misadecki/araneo-project/mechanics/araneo-cad.step

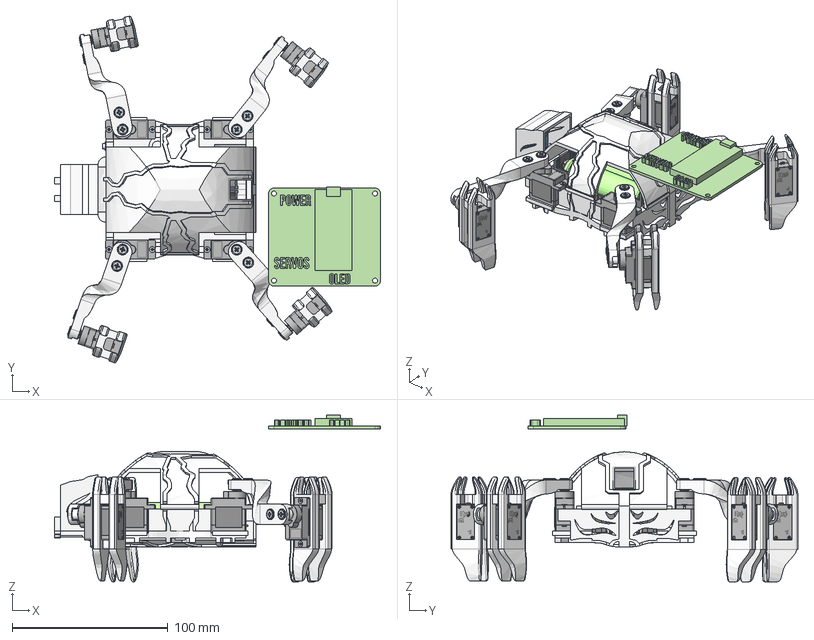
[picture p1: CAD file, 2026-08-21]
mechanics/araneo-cad.step
209.6 x 222.9 x 107.1 mm
SG90 - Micro Servo 9g - Tower Pro.1_Pe?a:1__Body10__SG90 - Micro Serv o 9g - Tower Pro.1_Pe�a:1__Body10 x 8
SG90 - Micro Servo 9g - Tower Pro.1_Pe?a:1__Body1__SG90 - Micro Servo 9g - Tower Pro.1_Pe�a:1__Body1 x 8
Cable Body
PH Countersunk flat head screw M2x0.4 x 6 x 16
SG90 - Micro Servo 9g - Tower Pro.1_Pe?a:1__Body8__SG90 - Micro Servo 9g - Tower Pro.1_Pe�a:1__Body8 x 8
SG90 - Micro Servo 9g - Tower Pro.1_Pe?a:1__Body12__SG90 - Micro Serv o 9g - Tower Pro.1_Pe�a:1__Body12 x 8
SG90 - Micro Servo 9g - Tower Pro.1_Pe?a:1__Body5__SG90 - Micro Servo 9g - Tower Pro.1_Pe�a:1__Body5 x 8
SG90 - Micro Servo 9g - Tower Pro.1_Pe?a:1__Body13__SG90 - Micro Serv o 9g - Tower Pro.1_Pe�a:1__Body13 x 8
Plain washer grade A HV200 M3 x 30
Bottom Body
SG90 - Micro Servo 9g - Tower Pro.1_Pe?a:1__Body11__SG90 - Micro Serv o 9g - Tower Pro.1_Pe�a:1__Body11 x 8
Hex socket head cap screw M2x0.40 x 4 x 2
PH Countersunk flat head screw M3x0.5 x 6 x 30
Pin 4
SG90 - Micro Servo 9g - Tower Pro.1_Pe?a:1__Body7__SG90 - Micro Servo 9g - Tower Pro.1_Pe�a:1__Body7 x 8
SG90 - Micro Servo 9g - Tower Pro.1_Pe?a:1__Body2__SG90 - Micro Servo 9g - Tower Pro.1_Pe�a:1__Body2 x 8
Imported5
Main Body
SG90 - Micro Servo 9g - Tower Pro.1_Pe?a:1__Body3__SG90 - Micro Servo 9g - Tower Pro.1_Pe�a:1__Body3 x 8
SG90 - Micro Servo 9g - Tower Pro.1_Pe?a:1__Body4__SG90 - Micro Servo 9g - Tower Pro.1_Pe�a:1__Body4 x 8
SG90 - Micro Servo 9g - Tower Pro.1_Pe?a:1__Body6__SG90 - Micro Servo 9g - Tower Pro.1_Pe�a:1__Body6 x 8
Mounting Hole 2
SG90 - Micro Servo 9g - Tower Pro.1_Pe?a:1__Body9__SG90 - Micro Servo 9g - Tower Pro.1_Pe�a:1__Body9 x 8
PCB
Cut-Extrude1
Servo Header x 8
Head
Screen
Pin 3
Left Leg x 2
First Pin
Mounting Hole 4
Screen Holder
Mounting Hole 3
Right Leg x 2
Pin 2
Vertical Leg Left x 2
Imported7
Imported6
Imported4
Mounting Hole 1
Vertical Leg Right x 2
Porta_18650__Contacto_2 x 2
Porta_18650__Carcasa x 2
Porta_18650__Contacto_1 x 2
Top Body
Screen Pad
