misadecki/araneo-project/ros2_ws/src/quadruped_description/meshes/femur_left.stl

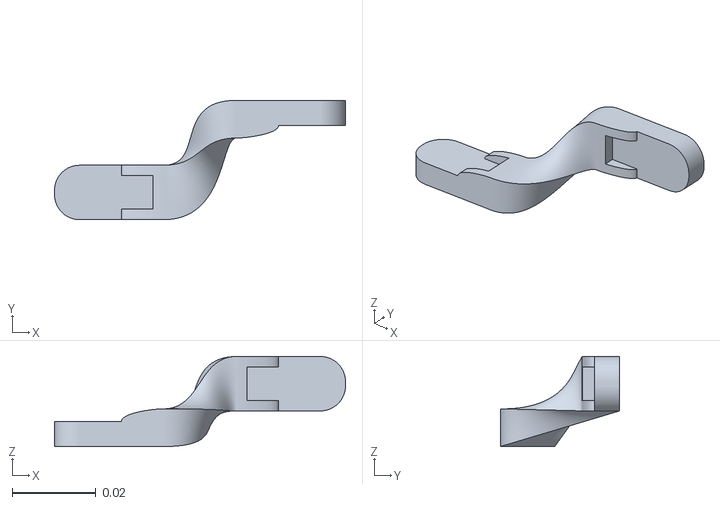
[picture p2: CAD file, 2026-11-03]
ros2_ws/src/quadruped_description/meshes/femur_left.stl
0.0695 x 0.0285 x 0.0215
