misadecki/araneo-project/ros2_ws/src/quadruped_description/meshes/body_bottom.stl

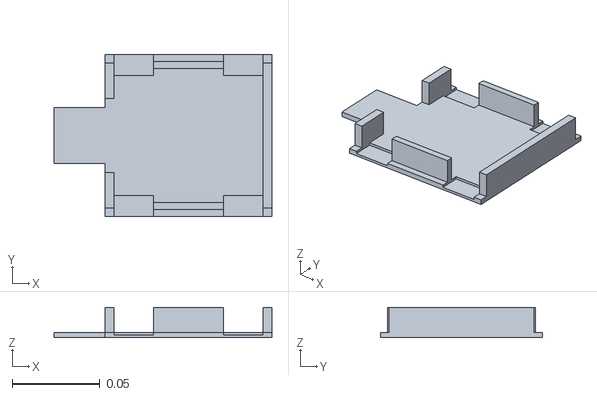
[picture p3: CAD file, 2026-11-03]
ros2_ws/src/quadruped_description/meshes/body_bottom.stl
0.124 x 0.0924 x 0.0172
