misadecki/araneo-project/ros2_ws/src/quadruped_description/meshes/tibia_left.stl

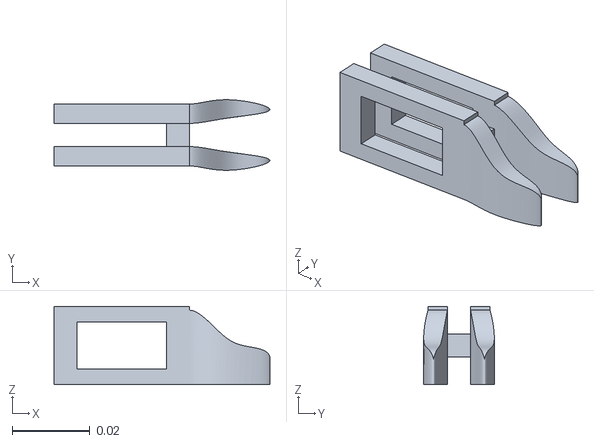
[picture p4: CAD file, 2026-11-03]
ros2_ws/src/quadruped_description/meshes/tibia_left.stl
0.0557 x 0.0182 x 0.0202
