misadecki/araneo-project/ros2_ws/src/quadruped_description/meshes/head.stl

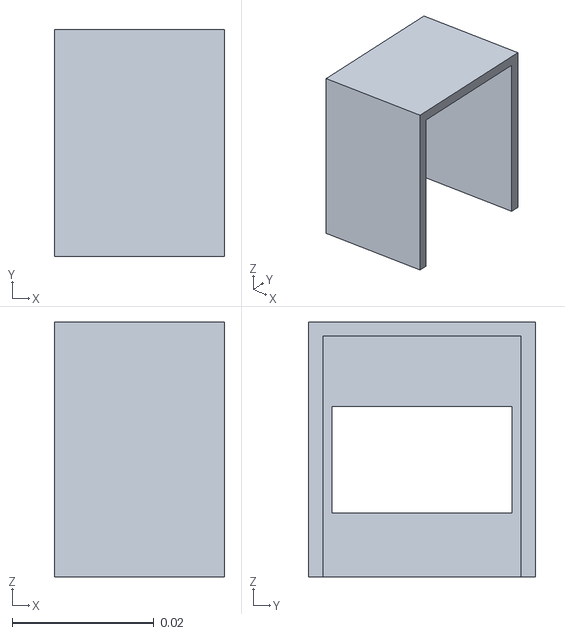
[picture p5: CAD file, 2026-11-03]
ros2_ws/src/quadruped_description/meshes/head.stl
0.024 x 0.032 x 0.036
