misadecki/araneo-project/ros2_ws/src/quadruped_description/meshes/body_top.stl

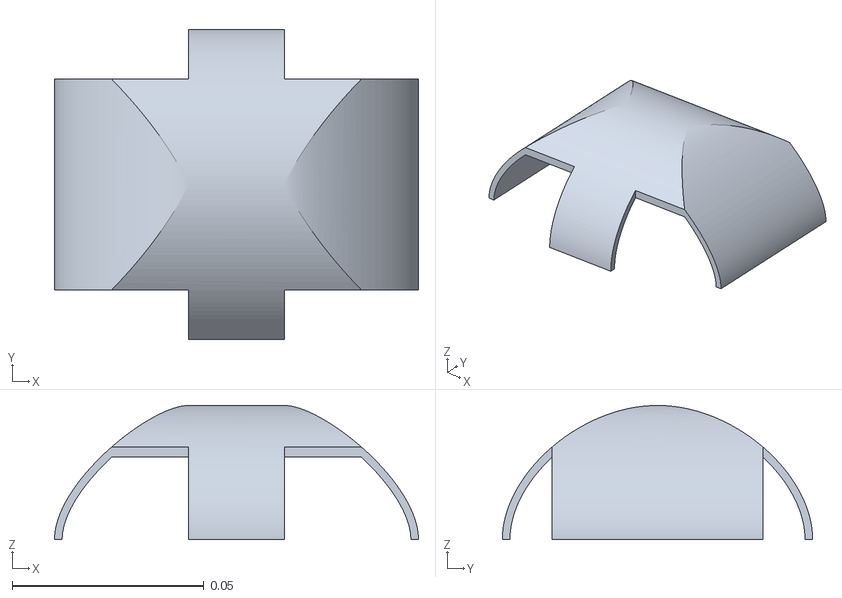
[picture p6: CAD file, 2026-11-03]
ros2_ws/src/quadruped_description/meshes/body_top.stl
0.095 x 0.081 x 0.035
