misadecki/araneo-project/ros2_ws/src/quadruped_description/meshes/electronics.stl

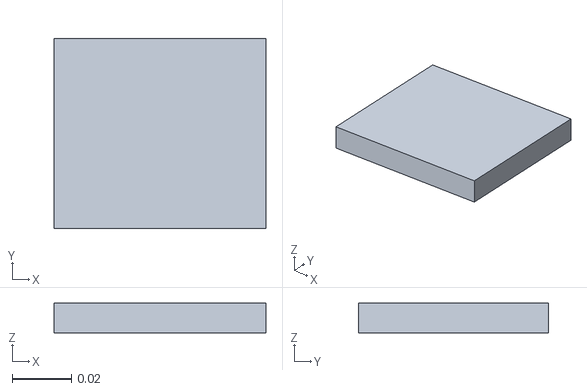
[picture p7: CAD file, 2026-11-03]
ros2_ws/src/quadruped_description/meshes/electronics.stl
0.0715 x 0.064 x 0.01
