misadecki/araneo-project/ros2_ws/src/quadruped_description/meshes/battery.stl

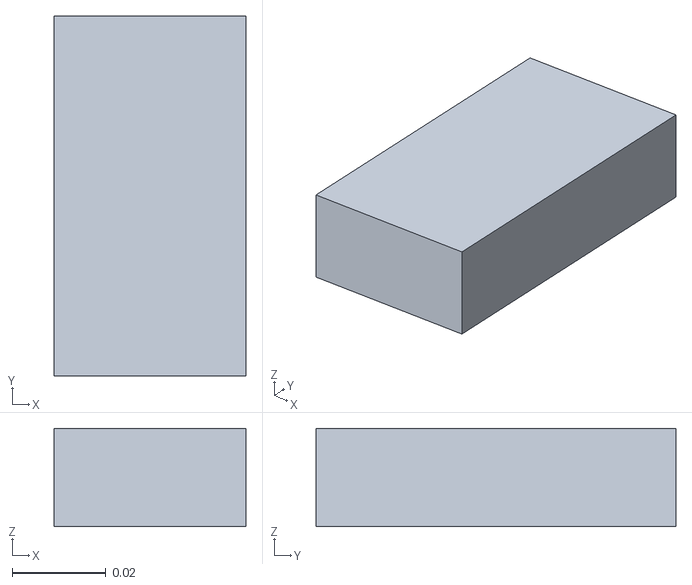
[picture p8: CAD file, 2026-11-03]
ros2_ws/src/quadruped_description/meshes/battery.stl
0.041 x 0.077 x 0.021
