misadecki/araneo-project/ros2_ws/src/quadruped_description/meshes/servo.stl

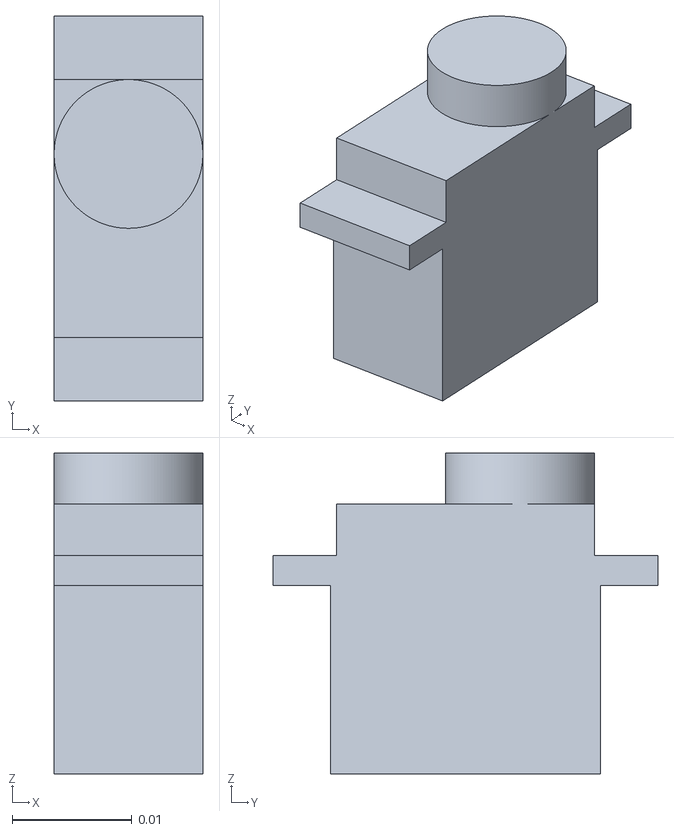
[picture p9: CAD file, 2026-11-03]
ros2_ws/src/quadruped_description/meshes/servo.stl
0.0124 x 0.0321 x 0.0268
