misadecki/araneo-project/(list of files, cad)

Other CAD files:
ros2_ws/src/quadruped_description/meshes/femur_right.stl
ros2_ws/src/quadruped_description/meshes/tibia_right.stl
mechanics/araneo-cad.stl
