misadecki/araneo-project/ros2_ws/src/quadruped_description/urdf/araneo.urdf

<!--URDF generated by ONSHAPE BY PTC INC, 1.223-->
<robot name="quadruped_description">
    <link name="battery">
        <inertial>
            <mass value="6.6297e-05" />
            <origin xyz="-7.51456e-18 5.50052e-18 0.0105" rpy="0 -0 0" />
            <inertia ixx="3.51927e-08" ixy="0" ixz="0" iyy="1.17235e-08" iyz="0" izz="4.20433e-08" />
        </inertial>
        <visual>
            <origin xyz="-7.41044e-18 7.51008e-18 0" rpy="0 -0 0" />
            <geometry>
                <mesh filename="package://quadruped_description/meshes/battery.stl" scale="1 1 1" />
            </geometry>
            <material name="0.615686_0.811765_0.929412_0.000000_0.000000">
                <color rgba="0.615686 0.811765 0.929412 1" />
            </material>
        </visual>
    </link>
    <link name="body_bottom">
        <inertial>
            <mass value="0.0529947" />
            <origin xyz="0.00498473 4.07013e-18 0.00426981" rpy="0 -0 0" />
            <inertia ixx="3.99559e-05" ixy="0" ixz="-1.63984e-06" iyy="6.26816e-05" iyz="0" izz="0.000100265" />
        </inertial>
        <visual>
            <origin xyz="-0.0415721 -1.04723e-18 0" rpy="0 -0 0" />
            <geometry>
                <mesh filename="package://quadruped_description/meshes/body_bottom.stl" scale="1 1 1" />
            </geometry>
            <material name="0.901961_0.901961_0.901961_0.000000_0.000000">
                <color rgba="0.901961 0.901961 0.901961 1" />
            </material>
        </visual>
    </link>
    <link name="body_top">
        <inertial>
            <mass value="0.0220922" />
            <origin xyz="-0.0475001 2.4544e-08 0.0202714" rpy="0 -0 0" />
            <inertia ixx="1.12547e-05" ixy="-7.95807e-12" ixz="5.44726e-11" iyy="1.96837e-05" iyz="-1.43156e-10" izz="2.66986e-05" />
        </inertial>
        <visual>
            <origin xyz="-0.095 0 0" rpy="0 -0 0" />
            <geometry>
                <mesh filename="package://quadruped_description/meshes/body_top.stl" scale="1 1 1" />
            </geometry>
            <material name="0.901961_0.901961_0.901961_0.000000_0.000000">
                <color rgba="0.901961 0.901961 0.901961 1" />
            </material>
        </visual>
    </link>
    <link name="electronics">
        <inertial>
            <mass value="4.576e-05" />
            <origin xyz="7.33348e-18 2.53543e-19 0.005" rpy="0 -0 0" />
            <inertia ixx="1.60007e-08" ixy="0" ixz="0" iyy="1.9876e-08" iyz="0" izz="3.51141e-08" />
        </inertial>
        <visual>
            <origin xyz="9.39275e-18 -9.86649e-19 0" rpy="0 -0 0" />
            <geometry>
                <mesh filename="package://quadruped_description/meshes/electronics.stl" scale="1 1 1" />
            </geometry>
            <material name="0.615686_0.811765_0.929412_0.000000_0.000000">
                <color rgba="0.615686 0.811765 0.929412 1" />
            </material>
        </visual>
    </link>
    <link name="femur_left">
        <inertial>
            <mass value="0.00841079" />
            <origin xyz="-0.0270347 -0.00708963 0.0113577" rpy="0 0.610865 0" />
            <inertia ixx="1.01501e-06" ixy="-1.14374e-06" ixz="-7.15637e-07" iyy="2.97273e-06" iyz="-3.8721e-07" izz="3.36401e-06" />
        </inertial>
        <visual>
            <origin xyz="0.00094194 0.004 -0.00126994" rpy="0 0.610865 0" />
            <geometry>
                <mesh filename="package://quadruped_description/meshes/femur_left.stl" scale="1 1 1" />
            </geometry>
            <material name="0.901961_0.901961_0.901961_0.000000_0.000000">
                <color rgba="0.901961 0.901961 0.901961 1" />
            </material>
        </visual>
    </link>
    <link name="femur_left_1">
        <inertial>
            <mass value="0.00841079" />
            <origin xyz="-0.0251522 -0.00708963 -0.0146913" rpy="0 -0.349066 0" />
            <inertia ixx="1.01501e-06" ixy="-1.14374e-06" ixz="-7.15637e-07" iyy="2.97273e-06" iyz="-3.8721e-07" izz="3.36401e-06" />
        </inertial>
        <visual>
            <origin xyz="0.00123853 0.004 0.000982877" rpy="0 -0.349066 0" />
            <geometry>
                <mesh filename="package://quadruped_description/meshes/femur_left.stl" scale="1 1 1" />
            </geometry>
            <material name="0.901961_0.901961_0.901961_0.000000_0.000000">
                <color rgba="0.901961 0.901961 0.901961 1" />
            </material>
        </visual>
    </link>
    <link name="femur_right">
        <inertial>
            <mass value="0.00841302" />
            <origin xyz="-0.0251523 -0.00708985 0.014691" rpy="0 0.349066 0" />
            <inertia ixx="1.01526e-06" ixy="-1.14408e-06" ixz="7.15827e-07" iyy="2.97363e-06" iyz="3.87284e-07" izz="3.36501e-06" />
        </inertial>
        <visual>
            <origin xyz="0.00123853 0.004 -0.000982877" rpy="0 0.349066 0" />
            <geometry>
                <mesh filename="package://quadruped_description/meshes/femur_right.stl" scale="1 1 1" />
            </geometry>
            <material name="0.901961_0.901961_0.901961_0.000000_0.000000">
                <color rgba="0.901961 0.901961 0.901961 1" />
            </material>
        </visual>
    </link>
    <link name="femur_right_1">
        <inertial>
            <mass value="0.00841302" />
            <origin xyz="-0.0270345 -0.00708985 -0.011358" rpy="0 -0.610865 0" />
            <inertia ixx="1.01526e-06" ixy="-1.14408e-06" ixz="7.15827e-07" iyy="2.97363e-06" iyz="3.87284e-07" izz="3.36501e-06" />
        </inertial>
        <visual>
            <origin xyz="0.00094194 0.004 0.00126994" rpy="0 -0.610865 0" />
            <geometry>
                <mesh filename="package://quadruped_description/meshes/femur_right.stl" scale="1 1 1" />
            </geometry>
            <material name="0.901961_0.901961_0.901961_0.000000_0.000000">
                <color rgba="0.901961 0.901961 0.901961 1" />
            </material>
        </visual>
    </link>
    <link name="head">
        <inertial>
            <mass value="0.00772393" />
            <origin xyz="0.0098935 0.016 0.0217151" rpy="0 -0 0" />
            <inertia ixx="2.34052e-06" ixy="0" ixz="-7.17769e-08" iyy="1.54989e-06" iyz="0" izz="1.68052e-06" />
        </inertial>
        <visual>
            <origin xyz="0.013 0.016 0" rpy="0 -0 0" />
            <geometry>
                <mesh filename="package://quadruped_description/meshes/head.stl" scale="1 1 1" />
            </geometry>
            <material name="0.901961_0.901961_0.901961_0.000000_0.000000">
                <color rgba="0.901961 0.901961 0.901961 1" />
            </material>
        </visual>
    </link>
    <link name="left_back_foot">
        <inertial>
            <mass value="1e-09" />
            <origin xyz="0 0 0" rpy="0 -0 0" />
            <inertia ixx="4e-14" ixy="0" ixz="0" iyy="4e-14" iyz="0" izz="4e-14" />
        </inertial>
    </link>
    <link name="left_front_foot">
        <inertial>
            <mass value="1e-09" />
            <origin xyz="0 0 0" rpy="0 -0 0" />
            <inertia ixx="4e-14" ixy="0" ixz="0" iyy="4e-14" iyz="0" izz="4e-14" />
        </inertial>
    </link>
    <link name="right_back_foot">
        <inertial>
            <mass value="1e-09" />
            <origin xyz="0 0 0" rpy="0 -0 0" />
            <inertia ixx="4e-14" ixy="0" ixz="0" iyy="4e-14" iyz="0" izz="4e-14" />
        </inertial>
    </link>
    <link name="right_front_foot">
        <inertial>
            <mass value="1e-09" />
            <origin xyz="0 0 0" rpy="0 -0 0" />
            <inertia ixx="4e-14" ixy="0" ixz="0" iyy="4e-14" iyz="0" izz="4e-14" />
        </inertial>
    </link>
    <link name="base_link" />
    <link name="servo">
        <inertial>
            <mass value="7.03502e-06" />
            <origin xyz="7.59738e-20 0.000331947 0.0123979" rpy="0 -0 0" />
            <inertia ixx="6.82657e-10" ixy="0" ixz="0" iyy="4.41973e-10" iyz="-2.85533e-11" izz="4.17681e-10" />
        </inertial>
        <visual>
            <origin xyz="3.25309e-19 4.01038e-19 0" rpy="0 -0 0" />
            <geometry>
                <mesh filename="package://quadruped_description/meshes/servo.stl" scale="1 1 1" />
            </geometry>
            <material name="0.615686_0.811765_0.929412_0.000000_0.000000">
                <color rgba="0.615686 0.811765 0.929412 1" />
            </material>
        </visual>
    </link>
    <link name="servo_1">
        <inertial>
            <mass value="7.03502e-06" />
            <origin xyz="7.59738e-20 0.000331947 0.0123979" rpy="0 -0 0" />
            <inertia ixx="6.82657e-10" ixy="0" ixz="0" iyy="4.41973e-10" iyz="-2.85533e-11" izz="4.17681e-10" />
        </inertial>
        <visual>
            <origin xyz="3.25309e-19 4.01038e-19 0" rpy="0 -0 0" />
            <geometry>
                <mesh filename="package://quadruped_description/meshes/servo.stl" scale="1 1 1" />
            </geometry>
            <material name="0.615686_0.811765_0.929412_0.000000_0.000000">
                <color rgba="0.615686 0.811765 0.929412 1" />
            </material>
        </visual>
    </link>
    <link name="servo_2">
        <inertial>
            <mass value="7.03502e-06" />
            <origin xyz="7.59738e-20 0.000331947 0.0123979" rpy="0 -0 0" />
            <inertia ixx="6.82657e-10" ixy="0" ixz="0" iyy="4.41973e-10" iyz="-2.85533e-11" izz="4.17681e-10" />
        </inertial>
        <visual>
            <origin xyz="3.25309e-19 4.01038e-19 0" rpy="0 -0 0" />
            <geometry>
                <mesh filename="package://quadruped_description/meshes/servo.stl" scale="1 1 1" />
            </geometry>
            <material name="0.615686_0.811765_0.929412_0.000000_0.000000">
                <color rgba="0.615686 0.811765 0.929412 1" />
            </material>
        </visual>
    </link>
    <link name="servo_3">
        <inertial>
            <mass value="7.03502e-06" />
            <origin xyz="7.59738e-20 0.000331947 0.0123979" rpy="0 -0 0" />
            <inertia ixx="6.82657e-10" ixy="0" ixz="0" iyy="4.41973e-10" iyz="-2.85533e-11" izz="4.17681e-10" />
        </inertial>
        <visual>
            <origin xyz="3.25309e-19 4.01038e-19 0" rpy="0 -0 0" />
            <geometry>
                <mesh filename="package://quadruped_description/meshes/servo.stl" scale="1 1 1" />
            </geometry>
            <material name="0.615686_0.811765_0.929412_0.000000_0.000000">
                <color rgba="0.615686 0.811765 0.929412 1" />
            </material>
        </visual>
    </link>
    <link name="servo_4">
        <inertial>
            <mass value="7.03502e-06" />
            <origin xyz="-2.49335e-19 -0.00421805 -0.0143521" rpy="0 -0 0" />
            <inertia ixx="6.82657e-10" ixy="0" ixz="0" iyy="4.41973e-10" iyz="-2.85533e-11" izz="4.17681e-10" />
        </inertial>
        <visual>
            <origin xyz="0 -0.00455 -0.02675" rpy="0 -0 0" />
            <geometry>
                <mesh filename="package://quadruped_description/meshes/servo.stl" scale="1 1 1" />
            </geometry>
            <material name="0.615686_0.811765_0.929412_0.000000_0.000000">
                <color rgba="0.615686 0.811765 0.929412 1" />
            </material>
        </visual>
    </link>
    <link name="servo_5">
        <inertial>
            <mass value="7.03502e-06" />
            <origin xyz="-2.49335e-19 -0.00421805 -0.0143521" rpy="0 -0 0" />
            <inertia ixx="6.82657e-10" ixy="0" ixz="0" iyy="4.41973e-10" iyz="-2.85533e-11" izz="4.17681e-10" />
        </inertial>
        <visual>
            <origin xyz="0 -0.00455 -0.02675" rpy="0 -0 0" />
            <geometry>
                <mesh filename="package://quadruped_description/meshes/servo.stl" scale="1 1 1" />
            </geometry>
            <material name="0.615686_0.811765_0.929412_0.000000_0.000000">
                <color rgba="0.615686 0.811765 0.929412 1" />
            </material>
        </visual>
    </link>
    <link name="servo_6">
        <inertial>
            <mass value="7.03502e-06" />
            <origin xyz="-2.49335e-19 -0.00421805 -0.0143521" rpy="0 -0 0" />
            <inertia ixx="6.82657e-10" ixy="0" ixz="0" iyy="4.41973e-10" iyz="-2.85533e-11" izz="4.17681e-10" />
        </inertial>
        <visual>
            <origin xyz="0 -0.00455 -0.02675" rpy="0 -0 0" />
            <geometry>
                <mesh filename="package://quadruped_description/meshes/servo.stl" scale="1 1 1" />
            </geometry>
            <material name="0.615686_0.811765_0.929412_0.000000_0.000000">
                <color rgba="0.615686 0.811765 0.929412 1" />
            </material>
        </visual>
    </link>
    <link name="servo_7">
        <inertial>
            <mass value="7.03502e-06" />
            <origin xyz="-2.49335e-19 -0.00421805 -0.0143521" rpy="0 -0 0" />
            <inertia ixx="6.82657e-10" ixy="0" ixz="0" iyy="4.41973e-10" iyz="-2.85533e-11" izz="4.17681e-10" />
        </inertial>
        <visual>
            <origin xyz="0 -0.00455 -0.02675" rpy="0 -0 0" />
            <geometry>
                <mesh filename="package://quadruped_description/meshes/servo.stl" scale="1 1 1" />
            </geometry>
            <material name="0.615686_0.811765_0.929412_0.000000_0.000000">
                <color rgba="0.615686 0.811765 0.929412 1" />
            </material>
        </visual>
    </link>
    <link name="tibia_left">
        <inertial>
            <mass value="0.00882206" />
            <origin xyz="0.0204135 0.00799998 -0.000970394" rpy="0 -0 0" />
            <inertia ixx="6.53102e-07" ixy="4.06634e-12" ixz="1.63163e-07" iyy="2.42342e-06" iyz="-1.10596e-12" izz="2.37905e-06" />
        </inertial>
        <visual>
            <origin xyz="0.0061 0.0304 0" rpy="0 -0 0" />
            <geometry>
                <mesh filename="package://quadruped_description/meshes/tibia_left.stl" scale="1 1 1" />
            </geometry>
            <material name="0.901961_0.901961_0.901961_0.000000_0.000000">
                <color rgba="0.901961 0.901961 0.901961 1" />
            </material>
        </visual>
    </link>
    <link name="tibia_left_1">
        <inertial>
            <mass value="0.00882206" />
            <origin xyz="0.0204135 0.00799998 -0.000970394" rpy="0 -0 0" />
            <inertia ixx="6.53102e-07" ixy="4.06633e-12" ixz="1.63163e-07" iyy="2.42342e-06" iyz="-1.10595e-12" izz="2.37905e-06" />
        </inertial>
        <visual>
            <origin xyz="0.0061 0.0304 0" rpy="0 -0 0" />
            <geometry>
                <mesh filename="package://quadruped_description/meshes/tibia_left.stl" scale="1 1 1" />
            </geometry>
            <material name="0.901961_0.901961_0.901961_0.000000_0.000000">
                <color rgba="0.901961 0.901961 0.901961 1" />
            </material>
        </visual>
    </link>
    <link name="tibia_right">
        <inertial>
            <mass value="0.00882206" />
            <origin xyz="0.0204135 -0.00800002 -0.000970394" rpy="0 -0 0" />
            <inertia ixx="6.53102e-07" ixy="4.0666e-12" ixz="1.63163e-07" iyy="2.42342e-06" iyz="-1.10602e-12" izz="2.37905e-06" />
        </inertial>
        <visual>
            <origin xyz="0.0061 0.0144 0" rpy="0 -0 0" />
            <geometry>
                <mesh filename="package://quadruped_description/meshes/tibia_right.stl" scale="1 1 1" />
            </geometry>
            <material name="0.901961_0.901961_0.901961_0.000000_0.000000">
                <color rgba="0.901961 0.901961 0.901961 1" />
            </material>
        </visual>
    </link>
    <link name="tibia_right_1">
        <inertial>
            <mass value="0.00882206" />
            <origin xyz="0.0204135 -0.00800002 -0.000970394" rpy="0 -0 0" />
            <inertia ixx="6.53102e-07" ixy="4.06659e-12" ixz="1.63163e-07" iyy="2.42342e-06" iyz="-1.10601e-12" izz="2.37905e-06" />
        </inertial>
        <visual>
            <origin xyz="0.0061 0.0144 0" rpy="0 -0 0" />
            <geometry>
                <mesh filename="package://quadruped_description/meshes/tibia_right.stl" scale="1 1 1" />
            </geometry>
            <material name="0.901961_0.901961_0.901961_0.000000_0.000000">
                <color rgba="0.901961 0.901961 0.901961 1" />
            </material>
        </visual>
    </link>
    <joint name="batteries" type="fixed">
        <origin xyz="0.00468333 -1.04723e-18 0.003" rpy="3.29597e-16 -3.29597e-16 1.5708" />
        <axis xyz="0 0 -1" />
        <parent link="body_bottom" />
        <child link="battery" />
    </joint>
    <joint name="bodies" type="fixed">
        <origin xyz="0.0534279 1.97695e-17 0.0172" rpy="5.89806e-17 -5.55112e-17 3.84913e-15" />
        <axis xyz="0 -1 0" />
        <parent link="body_bottom" />
        <child link="body_top" />
    </joint>
    <joint name="electronics" type="fixed">
        <origin xyz="7.1525e-19 1.73472e-18 0.021" rpy="6.16298e-33 -6.16298e-33 -1.5708" />
        <axis xyz="0 0 -1" />
        <parent link="battery" />
        <child link="electronics" />
    </joint>
    <joint name="head_body" type="fixed">
        <origin xyz="-0.0705721 -0.016 0.003" rpy="-5.89806e-17 -2.91514e-16 3.84913e-15" />
        <axis xyz="2.40934e-16 0 1" />
        <parent link="body_bottom" />
        <child link="head" />
    </joint>
    <joint name="left_back_coxa" type="revolute">
        <origin xyz="-2.77556e-17 0.00455 0.02675" rpy="1.5708 1.20082e-14 3.14159" />
        <axis xyz="0 -1 0" />
        <parent link="servo_1" />
        <child link="femur_left" />
        <limit effort="1" velocity="1" lower="-0.907571" upper="1.13446" />
    </joint>
    <joint name="left_back_coxa_servo" type="fixed">
        <origin xyz="0.0371779 -0.0401 0.0015" rpy="-2.84495e-16 -6.59195e-17 -1.5708" />
        <axis xyz="0 0 -1" />
        <parent link="body_bottom" />
        <child link="servo_1" />
    </joint>
    <joint name="left_back_foot" type="fixed">
        <origin xyz="0.04974 0.008027 -0.006747" rpy="-1.5708 -0 1.5708" />
        <axis xyz="0 0 1" />
        <parent link="tibia_left_1" />
        <child link="left_back_foot" />
    </joint>
    <joint name="left_back_tibia" type="revolute">
        <origin xyz="-0.0525502 -0.0165 0.0251987" rpy="3.14159 -0.610865 3.14159" />
        <axis xyz="0 0 1" />
        <parent link="femur_left" />
        <child link="servo_6" />
        <limit effort="1" velocity="1" lower="0" upper="3.08923" />
    </joint>
    <joint name="left_back_tibia_servo" type="fixed">
        <origin xyz="-2.77556e-17 0.0067 -0.01105" rpy="-1.5708 -1.0103e-14 -1.5708" />
        <axis xyz="-1.98254e-16 -1 0" />
        <parent link="servo_6" />
        <child link="tibia_left_1" />
    </joint>
    <joint name="left_front_coxa" type="revolute">
        <origin xyz="1.38778e-17 0.00455 0.02675" rpy="1.5708 -1.86759e-15 -3.03917e-15" />
        <axis xyz="0 -1 0" />
        <parent link="servo" />
        <child link="femur_left_1" />
        <limit effort="1" velocity="1" lower="-0.872665" upper="1.16937" />
    </joint>
    <joint name="left_front_coxa_servo" type="fixed">
        <origin xyz="-0.0253221 -0.0401 0.0015" rpy="-3.46945e-18 3.46945e-18 1.5708" />
        <axis xyz="0 0 -1" />
        <parent link="body_bottom" />
        <child link="servo" />
    </joint>
    <joint name="left_front_foot" type="fixed">
        <origin xyz="0.04974 0.008027 -0.006387" rpy="-1.5708 -5.55112e-17 1.5708" />
        <axis xyz="0 0 1" />
        <parent link="tibia_left" />
        <child link="left_front_foot" />
    </joint>
    <joint name="left_front_tibia" type="revolute">
        <origin xyz="-0.0511252 -0.0155 -0.0276535" rpy="3.14159 0.349066 3.14159" />
        <axis xyz="0 0 1" />
        <parent link="femur_left_1" />
        <child link="servo_7" />
        <limit effort="1" velocity="1" lower="0" upper="3.08923" />
    </joint>
    <joint name="left_front_tibia_servo" type="fixed">
        <origin xyz="0 0.0067 -0.01105" rpy="-1.5708 5.55112e-16 -1.5708" />
        <axis xyz="-1.98254e-16 -1 0" />
        <parent link="servo_7" />
        <child link="tibia_left" />
    </joint>
    <joint name="origin" type="fixed">
        <origin xyz="0 0 0" rpy="-1.73472e-18 -9.24446e-33 2.76101e-30" />
        <axis xyz="0 0 -1" />
        <parent link="base_link" />
        <child link="body_bottom" />
    </joint>
    <joint name="right_back_coxa" type="revolute">
        <origin xyz="1.38778e-17 0.00455 0.02675" rpy="1.5708 -9.18284e-15 -9.97054e-15" />
        <axis xyz="0 -1 0" />
        <parent link="servo_3" />
        <child link="femur_right_1" />
        <limit effort="1" velocity="1" lower="-1.13446" upper="0.907571" />
    </joint>
    <joint name="right_back_coxa_servo" type="fixed">
        <origin xyz="0.0371779 0.0401 0.0015" rpy="-2.84495e-16 -6.59195e-17 -1.5708" />
        <axis xyz="0 0 -1" />
        <parent link="body_bottom" />
        <child link="servo_3" />
    </joint>
    <joint name="right_back_foot" type="fixed">
        <origin xyz="0.04974 -0.007973 -0.006747" rpy="-1.5708 -0 1.5708" />
        <axis xyz="0 0 1" />
        <parent link="tibia_right_1" />
        <child link="right_back_foot" />
    </joint>
    <joint name="right_back_tibia" type="revolute">
        <origin xyz="-0.0525502 -0.0165 -0.0251987" rpy="4.81199e-15 -0.610865 -8.44131e-15" />
        <axis xyz="0 0 1" />
        <parent link="femur_right_1" />
        <child link="servo_5" />
        <limit effort="1" velocity="1" lower="-3.08923" upper="7.10543e-15" />
    </joint>
    <joint name="right_back_tibia_servo" type="fixed">
        <origin xyz="-1.38778e-17 0.0067 -0.01105" rpy="1.5708 1.11022e-16 -1.5708" />
        <axis xyz="0 1 0" />
        <parent link="servo_5" />
        <child link="tibia_right_1" />
    </joint>
    <joint name="right_front_coxa" type="revolute">
        <origin xyz="6.93889e-18 0.00455 0.02675" rpy="1.5708 1.72071e-15 3.14159" />
        <axis xyz="0 -1 0" />
        <parent link="servo_2" />
        <child link="femur_right" />
        <limit effort="1" velocity="1" lower="-1.16937" upper="0.872665" />
    </joint>
    <joint name="right_front_coxa_servo" type="fixed">
        <origin xyz="-0.0253221 0.0401 0.0015" rpy="-3.46945e-18 3.46945e-18 1.5708" />
        <axis xyz="0 0 -1" />
        <parent link="body_bottom" />
        <child link="servo_2" />
    </joint>
    <joint name="right_front_foot" type="fixed">
        <origin xyz="0.04974 -0.007973 -0.006747" rpy="-1.5708 -0 1.5708" />
        <axis xyz="0 0 1" />
        <parent link="tibia_right" />
        <child link="right_front_foot" />
    </joint>
    <joint name="right_front_tibia" type="revolute">
        <origin xyz="-0.0511252 -0.0165 0.0276535" rpy="-1.90177e-14 0.349066 -5.68686e-14" />
        <axis xyz="0 0 1" />
        <parent link="femur_right" />
        <child link="servo_4" />
        <limit effort="1" velocity="1" lower="-3.08923" upper="5.41789e-14" />
    </joint>
    <joint name="right_front_tibia_servo" type="fixed">
        <origin xyz="1.38778e-17 0.0067 -0.01105" rpy="1.5708 5.55112e-17 -1.5708" />
        <axis xyz="0 1 0" />
        <parent link="servo_4" />
        <child link="tibia_right" />
    </joint>
</robot>
