misadecki/araneo-project/electronics/araneo-mainboard/araneo-mainboard.kicad_pcb

## KiCad design electronics/araneo-mainboard/araneo-mainboard.kicad_pcb (2026-10-09)

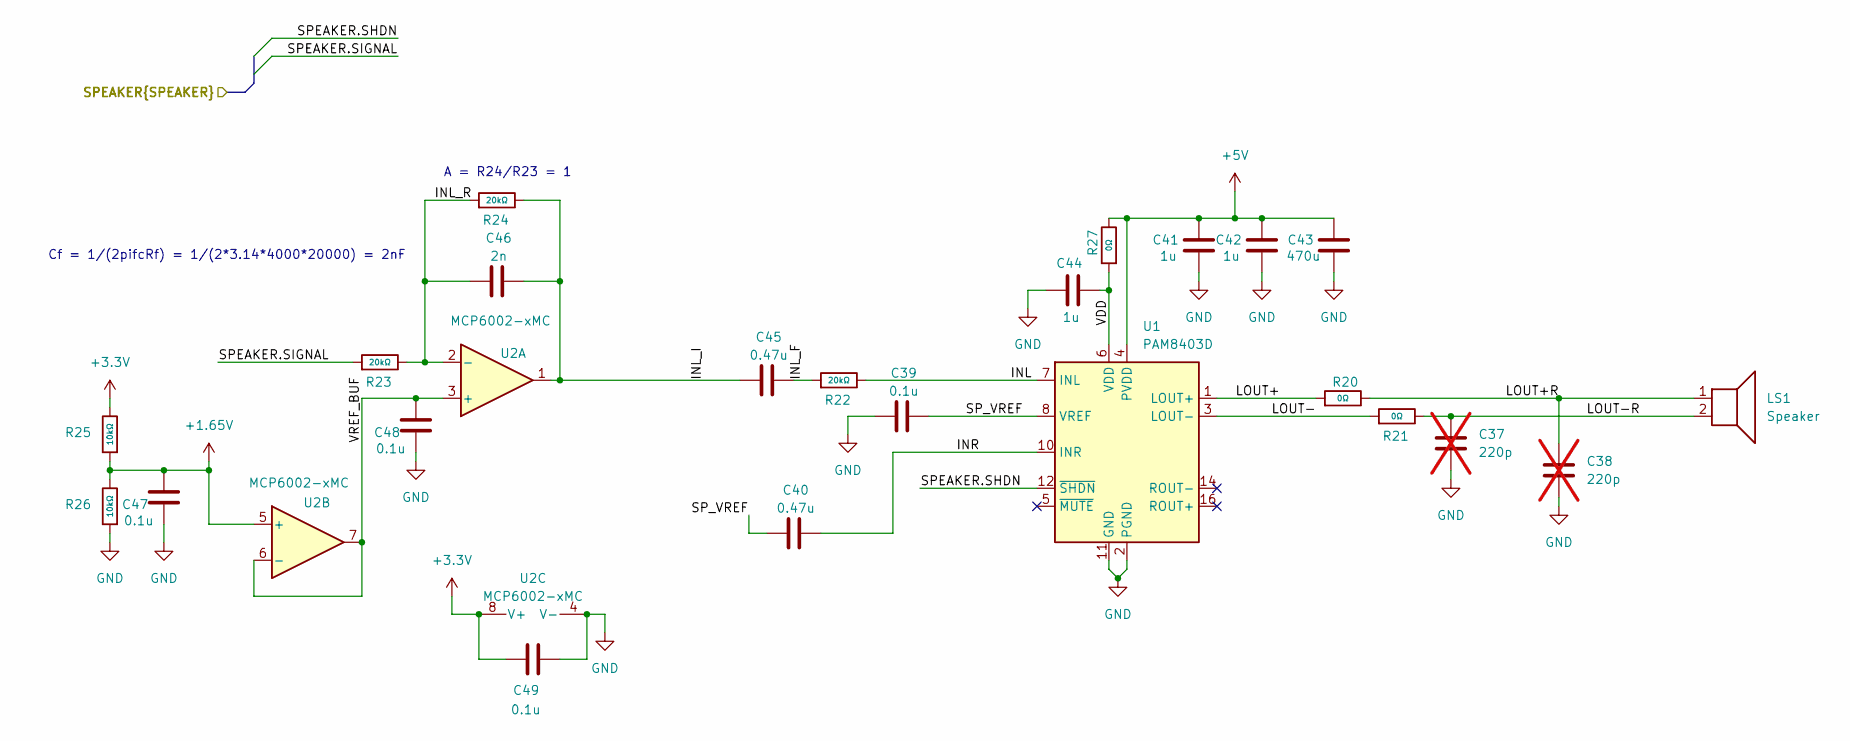
[picture p10: schematic speaker.kicad_sch]

Parts:
C37, C38: 220p; C_0603; not fitted
C39, C47, C48, C49: 0.1u; C_0402
C40, C45: 0.47u; C_0402
C41, C42, C44: 1u; C_0402
C43: 470u; CP_Radial_D10.0mm_P5.00mm
C46: 2n; C_0603
LS1: Speaker; ScrewTerminal_1x02_P3.5mm_Blue
R20, R21, R27: 0Ω; R_0603; Overload Voltage (Max) 50V; Tolerance ±1%; Part 0402WGF1201TCE; LCSC C25862
R22, R23, R24: 20kΩ; R_0603; Overload Voltage (Max) 50V; Tolerance ±1%; Part 0402WGF1201TCE; LCSC C25862
R25, R26: 10kΩ; R_0402; Overload Voltage (Max) 50V; Tolerance ±1%; Part 0402WGF1201TCE; LCSC C25862
U1: PAM8403D; SOIC-16_3.9x9.9mm_P1.27mm
U2: MCP6002-xMC; SOIC-8_L4.9-W3.9-P1.27-LS6.0-BL

Connections:
+1.65V: C47.2, R25.1, R26.2, U2.5 (+)
+3.3V: C49.2, R25.2, U2.8 (V+); also elsewhere on the board
+5V: C41.2, C42.2, C43.2, R27.2, U1.4 (PVDD), U1.13 (PVDD); also elsewhere on the board
/MCU/SPEAKER.SHDN: U1.12 (~SHDN); also elsewhere on the board
/MCU/SPEAKER.SIGNAL: R23.1; also elsewhere on the board
/Speaker/INL: R22.2, U1.7 (INL)
/Speaker/INL_F: C45.2, R22.1
/Speaker/INL_I: C45.1, C46.2, R24.2, U2.1
/Speaker/INL_R: C46.1, R23.2, R24.1, U2.2 (-)
/Speaker/INR: C40.2, U1.10 (INR)
/Speaker/LOUT+: R20.1, U1.1 (LOUT+)
/Speaker/LOUT+R: C38.1, LS1.1, R20.2
/Speaker/LOUT-: R21.1, U1.3 (LOUT-)
/Speaker/LOUT-R: C37.1, LS1.2, R21.2
/Speaker/SP_VREF: C39.2, C40.1, U1.8 (VREF)
/Speaker/VDD: C44.1, R27.1, U1.6 (VDD)
/Speaker/VREF_BUF: C48.2, U2.3 (+), U2.6 (-), U2.7
GND: C37.2, C38.2, C39.1, C41.1, C42.1, C43.1, C44.2, C47.1, C48.1, C49.1, R26.1, U1.2 (PGND), U1.11 (GND), U1.15 (PGND), U2.4 (V-); also elsewhere on the board

Notes on the sheet:
Cf = 1/(2pifcRf) = 1/(2*3.14*4000*20000) = 2nF
A = R24/R23 = 1

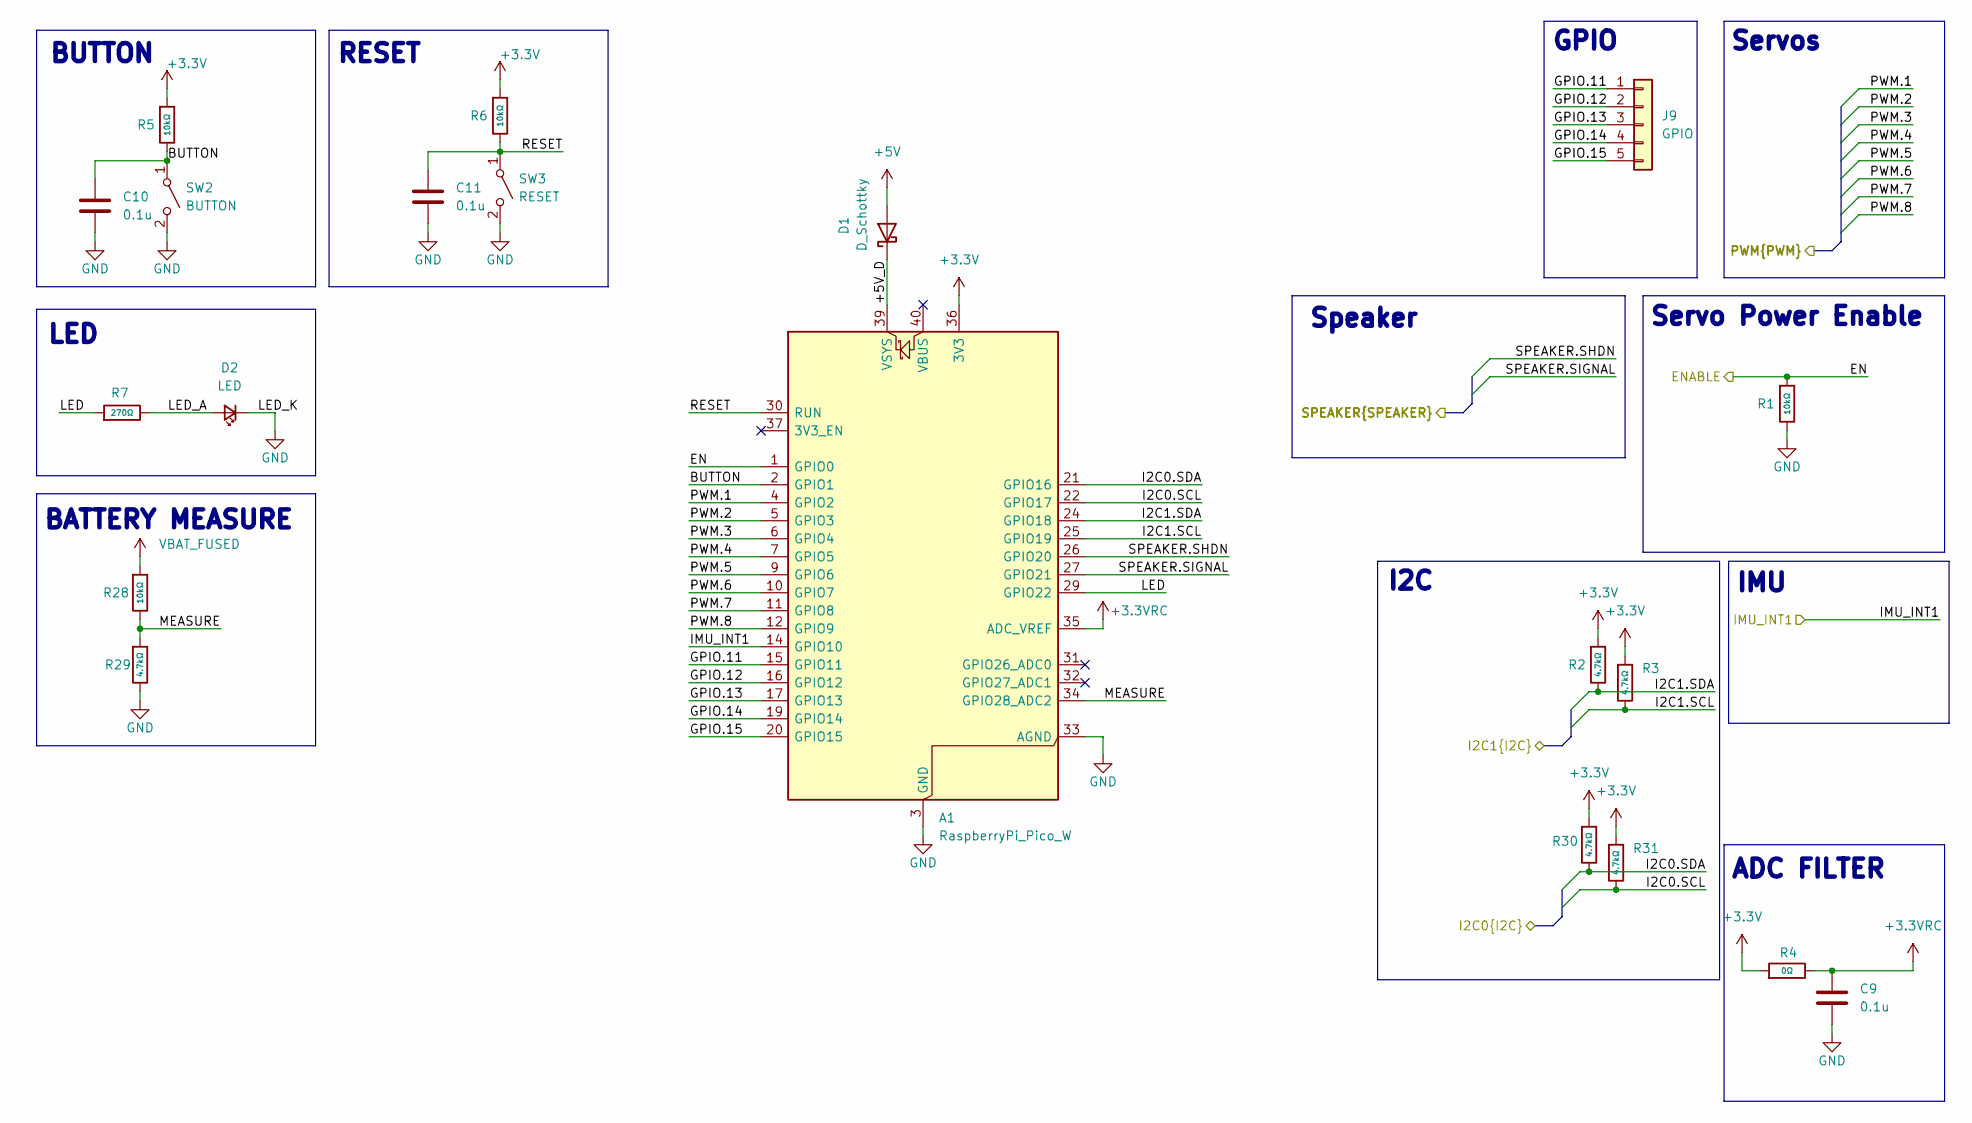
[picture p11: schematic mcu.kicad_sch]

Parts:
A1: RaspberryPi_Pico_W; RaspberryPi_Pico_Common_THT
C9: 0.1u; C_0603
C10, C11: 0.1u; C_0402
D1: D_Schottky; SOD-123
D2: LED; D_0603
J9: GPIO; PinHeader_1x05_P2.54mm_Vertical
R1, R5, R6, R28: 10kΩ; R_0402; Overload Voltage (Max) 50V; Tolerance ±1%; Part 0402WGF1201TCE; LCSC C25862
R2, R3, R29, R30, R31: 4.7kΩ; R_0402; Overload Voltage (Max) 50V; Tolerance ±1%; Part 0402WGF1201TCE; LCSC C25862
R4: 0Ω; R_0603; Overload Voltage (Max) 50V; Tolerance ±1%; Part 0402WGF1201TCE; LCSC C25862
R7: 270Ω; R_0603; Overload Voltage (Max) 50V; Tolerance ±1%; Part 0402WGF1201TCE; LCSC C25862
SW2: BUTTON; ScrewTerminal_1x02_P3.5mm_Blue
SW3: RESET; SW_SPST_TL3305B

Connections:
+3.3V: A1.36 (3V3), R2.1, R3.1, R4.1, R5.1, R6.1, R30.1, R31.1; also elsewhere on the board
+3.3VRC: A1.35 (ADC_VREF), C9.1, R4.2
+5V: D1.2 (A); also elsewhere on the board
/IMU/I2C1.SCL: A1.25 (GPIO19), R3.2; also elsewhere on the board
/IMU/I2C1.SDA: A1.24 (GPIO18), R2.2; also elsewhere on the board
/MCU/+5V_D: A1.39 (VSYS), D1.1 (K)
/MCU/BUTTON: A1.2 (GPIO1), C10.1, R5.2, SW2.1 (A)
/MCU/EN: A1.1 (GPIO0), R1.1; also elsewhere on the board
/MCU/GPIO.11: A1.15 (GPIO11), J9.1
/MCU/GPIO.12: A1.16 (GPIO12), J9.2
/MCU/GPIO.13: A1.17 (GPIO13), J9.3
/MCU/GPIO.14: A1.19 (GPIO14), J9.4
/MCU/GPIO.15: A1.20 (GPIO15), J9.5
/MCU/I2C0.SCL: A1.22 (GPIO17), R31.2; also elsewhere on the board
/MCU/I2C0.SDA: A1.21 (GPIO16), R30.2; also elsewhere on the board
/MCU/IMU_INT1: A1.14 (GPIO10); also elsewhere on the board
/MCU/LED: A1.29 (GPIO22), R7.1
/MCU/LED_A: D2.2 (A), R7.2
/MCU/MEASURE: A1.34 (GPIO28_ADC2), R28.2, R29.1
/MCU/PWM.1: A1.4 (GPIO2); also elsewhere on the board
/MCU/PWM.2: A1.5 (GPIO3); also elsewhere on the board
/MCU/PWM.3: A1.6 (GPIO4); also elsewhere on the board
/MCU/PWM.4: A1.7 (GPIO5); also elsewhere on the board
/MCU/PWM.5: A1.9 (GPIO6); also elsewhere on the board
/MCU/PWM.6: A1.10 (GPIO7); also elsewhere on the board
/MCU/PWM.7: A1.11 (GPIO8); also elsewhere on the board
/MCU/PWM.8: A1.12 (GPIO9); also elsewhere on the board
/MCU/RESET: A1.30 (RUN), C11.1, R6.2, SW3.1 (A)
/MCU/SPEAKER.SHDN: A1.26 (GPIO20); also elsewhere on the board
/MCU/SPEAKER.SIGNAL: A1.27 (GPIO21); also elsewhere on the board
GND: A1.3 (GND), A1.8 (GND), A1.13 (GND), A1.18 (GND), A1.23 (GND), A1.28 (GND), A1.33 (AGND), A1.38 (GND), C9.2, C10.2, C11.2, D2.1 (K), R1.2, R29.2, SW2.2 (B), SW3.2 (B); also elsewhere on the board
VBAT_FUSED: R28.1; also elsewhere on the board

Notes on the sheet:
I2C
RESET
BATTERY MEASURE
IMU
GPIO
LED
Servo Power Enable
Servos
BUTTON
Speaker
ADC FILTER

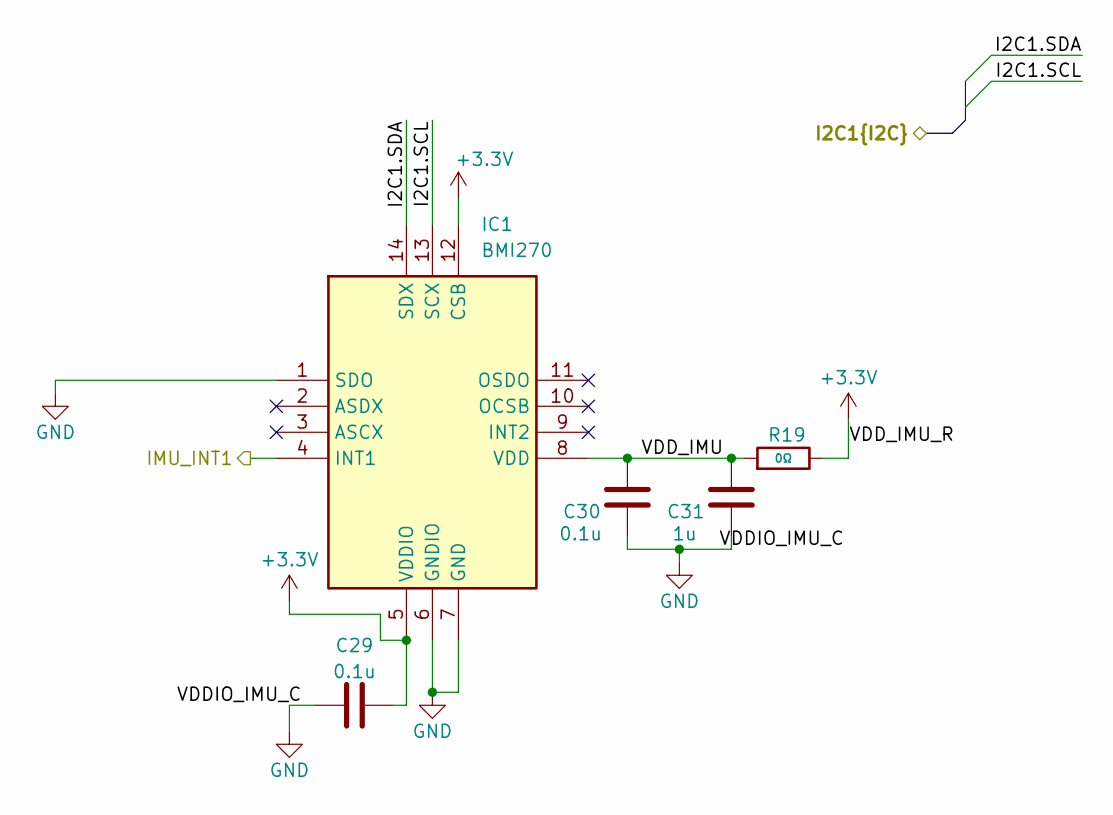
[picture p12: schematic imu.kicad_sch]

Parts:
C29, C30: 0.1u; C_0402
C31: 1u; C_0402
IC1: BMI270; Mouser Part Number 262-BMI270
R19: 0Ω; R_0603; Overload Voltage (Max) 50V; Tolerance ±1%; Part 0402WGF1201TCE; LCSC C25862

Connections:
+3.3V: C29.2, IC1.5 (VDDIO), IC1.12 (CSB), R19.2; also elsewhere on the board
/IMU/I2C1.SCL: IC1.13 (SCX); also elsewhere on the board
/IMU/I2C1.SDA: IC1.14 (SDX); also elsewhere on the board
/IMU/VDD_IMU: C30.2, C31.2, IC1.8 (VDD), R19.1
/MCU/IMU_INT1: IC1.4 (INT1); also elsewhere on the board
GND: C29.1, C30.1, C31.1, IC1.1 (SDO), IC1.6 (GNDIO), IC1.7 (GND); also elsewhere on the board

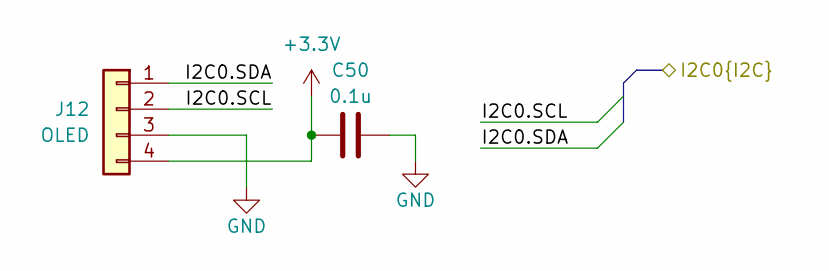
[picture p13: schematic oled.kicad_sch]

Parts:
C50: 0.1u; C_0402
J12: OLED; JST_XH_B4B-XH-A_1x04_P2.50mm_Vertical

Connections:
+3.3V: C50.1, J12.4; also elsewhere on the board
/MCU/I2C0.SCL: J12.2; also elsewhere on the board
/MCU/I2C0.SDA: J12.1; also elsewhere on the board
GND: C50.2, J12.3; also elsewhere on the board

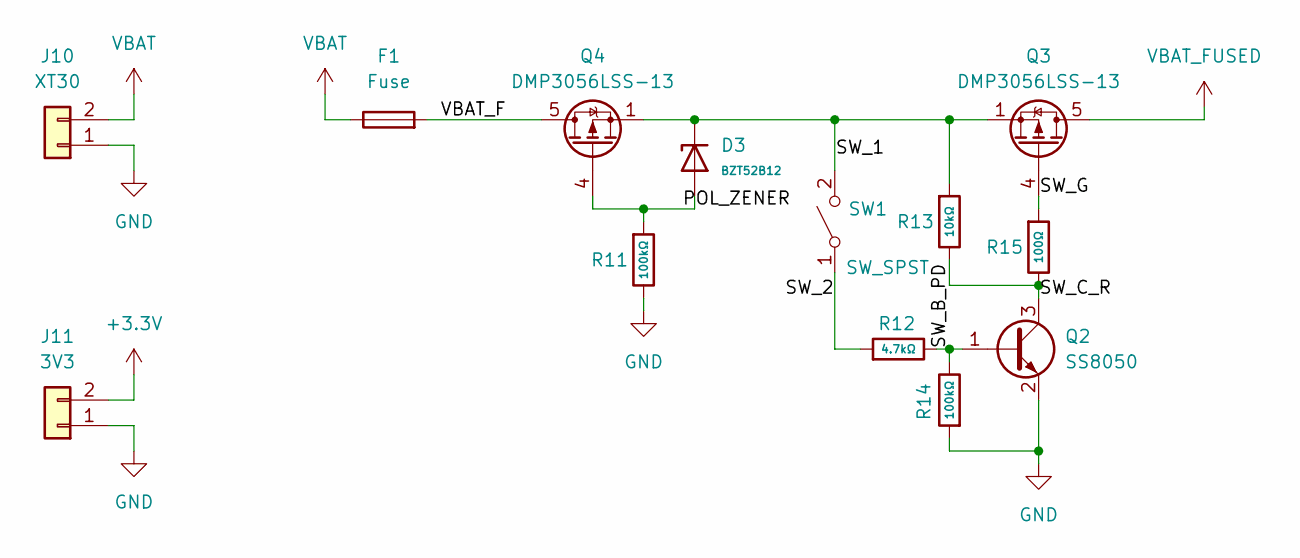
[picture p14: schematic power.kicad_sch]

Parts:
D3: BZT52B12; D_SOD-123; Zener Voltage (Range) 11.76V~12.24V; Zener Voltage (Nom) 12V; Part BZT52B12; LCSC C22395569
F1: Fuse; 3568
J10: XT30; AMASS_XT30U-F_1x02_P5.0mm_Vertical
J11: 3V3; PinHeader_1x02_P2.54mm_Vertical
Q2: SS8050; SOT-23
Q3, Q4: DMP3056LSS-13; SO-8
R11, R14: 100kΩ; R_0402; Overload Voltage (Max) 50V; Tolerance ±1%; Part 0402WGF1201TCE; LCSC C25862
R12: 4.7kΩ; R_0402; Overload Voltage (Max) 50V; Tolerance ±1%; Part 0402WGF1201TCE; LCSC C25862
R13: 10kΩ; R_0402; Overload Voltage (Max) 50V; Tolerance ±1%; Part 0402WGF1201TCE; LCSC C25862
R15: 100Ω; R_0402; Overload Voltage (Max) 50V; Tolerance ±1%; Part 0402WGF1201TCE; LCSC C25862
SW1: SW_SPST; ScrewTerminal_1x02_P3.5mm_Blue

Connections:
+3.3V: J11.2; also elsewhere on the board
/Power/POL_ZENER: D3.2, Q4.4 (G), R11.1
/Power/SW_1: D3.1, Q3.1 (S), Q3.2 (S), Q3.3 (S), Q4.1 (S), Q4.2 (S), Q4.3 (S), R13.1, SW1.2 (B)
/Power/SW_2: R12.1, SW1.1 (A)
/Power/SW_B_PD: Q2.1 (B), R12.2, R14.2
/Power/SW_C_R: Q2.3 (C), R13.2, R15.2
/Power/SW_G: Q3.4 (G), R15.1
/Power/VBAT_F: F1.2, Q4.5 (D), Q4.6 (D), Q4.7 (D), Q4.8 (D)
GND: J10.1, J11.1, Q2.2 (E), R11.2, R14.1; also elsewhere on the board
VBAT: F1.1, J10.2
VBAT_FUSED: Q3.5 (D), Q3.6 (D), Q3.7 (D), Q3.8 (D); also elsewhere on the board

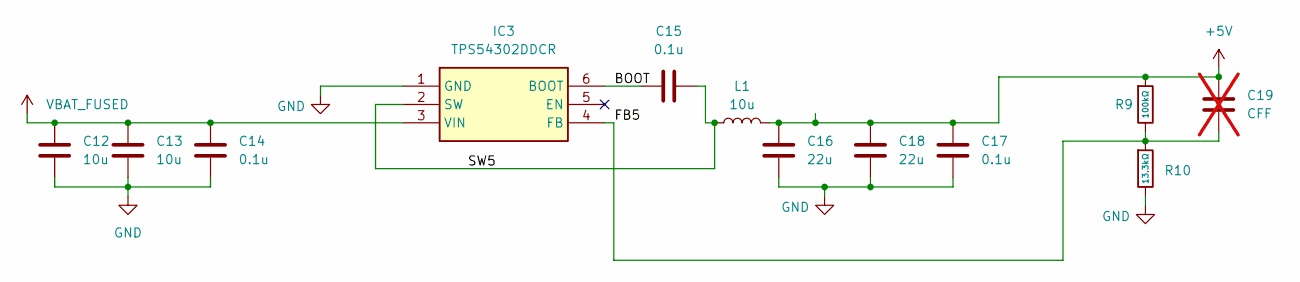
[picture p15: schematic pico-power.kicad_sch]

Parts:
C12, C13: 10u; C_0603
C14, C15, C17: 0.1u; C_0402
C16, C18: 22u; C_0805
C19: CFF; C_0603; not fitted
IC3: TPS54302DDCR; SOT95P280X110-6N; Mouser Part Number 595-TPS54302DDCR
L1: 10u; PA4302103NLT
R9: 100kΩ; R_0402; Overload Voltage (Max) 50V; Tolerance ±1%; Part 0402WGF1201TCE; LCSC C25862
R10: 13.3kΩ; R_0402; Overload Voltage (Max) 50V; Tolerance ±1%; Part 0402WGF1201TCE; LCSC C25862

Connections:
+5V: C16.1, C17.2, C18.1, C19.2, L1.2, R9.1; also elsewhere on the board
/Power 5V/BOOT: C15.1, IC3.6 (BOOT)
/Power 5V/FB5: C19.1, IC3.4 (FB), R9.2, R10.1
/Power 5V/SW5: C15.2, IC3.2 (SW), L1.1
GND: C12.2, C13.2, C14.2, C16.2, C17.1, C18.2, IC3.1 (GND), R10.2; also elsewhere on the board
VBAT_FUSED: C12.1, C13.1, C14.1, IC3.3 (VIN); also elsewhere on the board

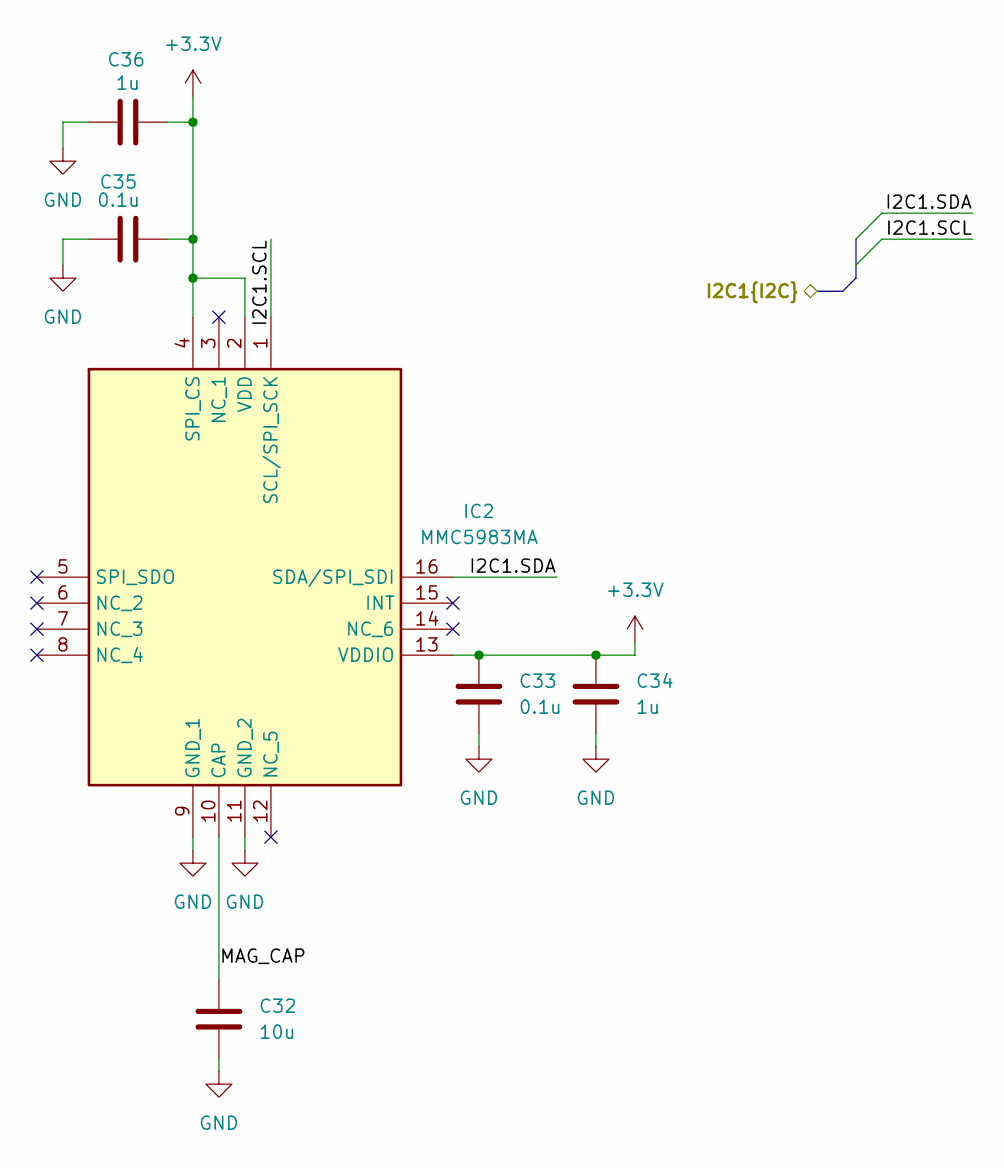
[picture p16: schematic magnetometer.kicad_sch]

Parts:
C32: 10u; C_0603
C33, C35: 0.1u; C_0402
C34, C36: 1u; C_0402
IC2: MMC5983MA; Mouser Part Number 438-MMC5983MA

Connections:
+3.3V: C33.1, C34.1, C35.2, C36.2, IC2.2 (VDD), IC2.4 (SPI_CS), IC2.13 (VDDIO); also elsewhere on the board
/IMU/I2C1.SCL: IC2.1 (SCL/SPI_SCK); also elsewhere on the board
/IMU/I2C1.SDA: IC2.16 (SDA/SPI_SDI); also elsewhere on the board
/Magnetometer/MAG_CAP: C32.1, IC2.10 (CAP)
GND: C32.2, C33.2, C34.2, C35.1, C36.1, IC2.9 (GND_1), IC2.11 (GND_2); also elsewhere on the board

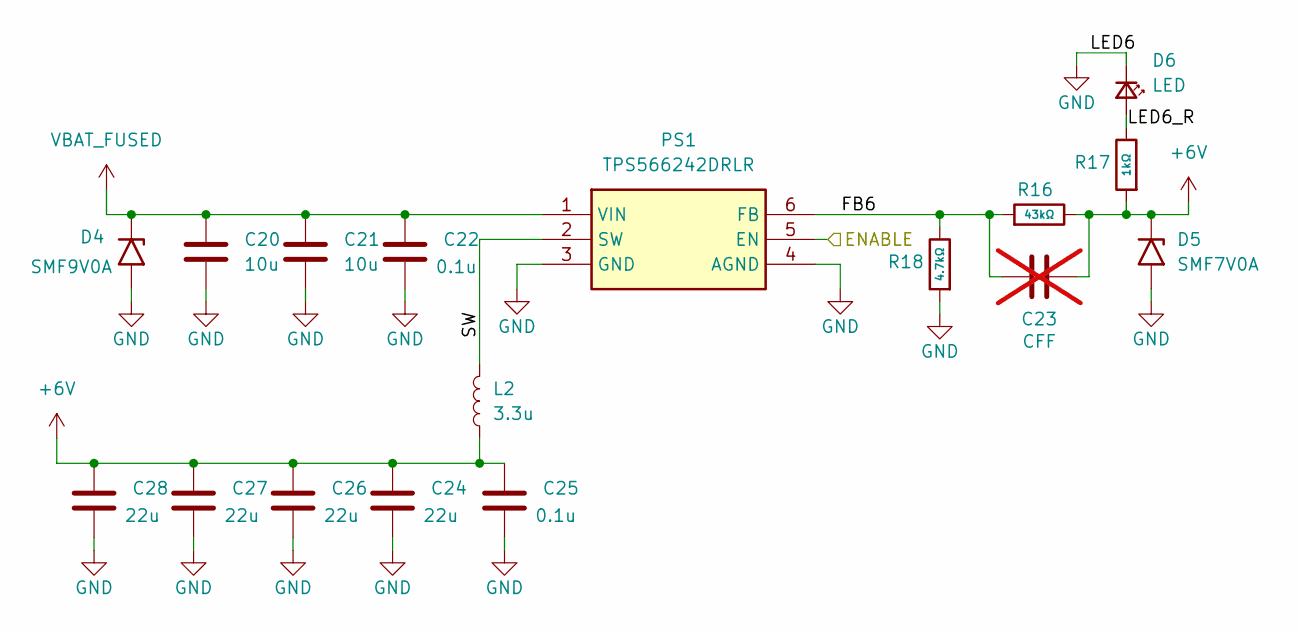
[picture p17: schematic servo_power.kicad_sch]

Parts:
C20, C21: 10u; C_0603
C22, C25: 0.1u; C_0402
C23: CFF; C_0603; not fitted
C24, C26, C27, C28: 22u; C_0805
D4: SMF9V0A; D_SMF
D5: SMF7V0A; D_SOD-123
D6: LED; D_0603
L2: 3.3u; INDPM112100X400N
PS1: TPS566242DRLR; SOT50P160X60-6N; Mouser Part Number 595-TPS566242DRLR
R16: 43kΩ; R_0402; Overload Voltage (Max) 50V; Tolerance ±1%; Part 0402WGF1201TCE; LCSC C25862
R17: 1kΩ; R_0402; Overload Voltage (Max) 50V; Tolerance ±1%; Part 0402WGF1201TCE; LCSC C25862
R18: 4.7kΩ; R_0402; Overload Voltage (Max) 50V; Tolerance ±1%; Part 0402WGF1201TCE; LCSC C25862

Connections:
+6V: C23.2, C24.1, C25.1, C26.1, C27.1, C28.1, D5.1 (A1), L2.1, R16.2, R17.1; also elsewhere on the board
/MCU/EN: PS1.5 (EN); also elsewhere on the board
/Power 6V/FB6: C23.1, PS1.6 (FB), R16.1, R18.2
/Power 6V/LED6_R: D6.2 (A), R17.2
/Power 6V/SW: L2.2, PS1.2 (SW)
GND: C20.2, C21.2, C22.2, C24.2, C25.2, C26.2, C27.2, C28.2, D4.2 (A2), D5.2 (A2), D6.1 (K), PS1.3 (GND), PS1.4 (AGND), R18.1; also elsewhere on the board
VBAT_FUSED: C20.1, C21.1, C22.1, D4.1 (A1), PS1.1 (VIN); also elsewhere on the board

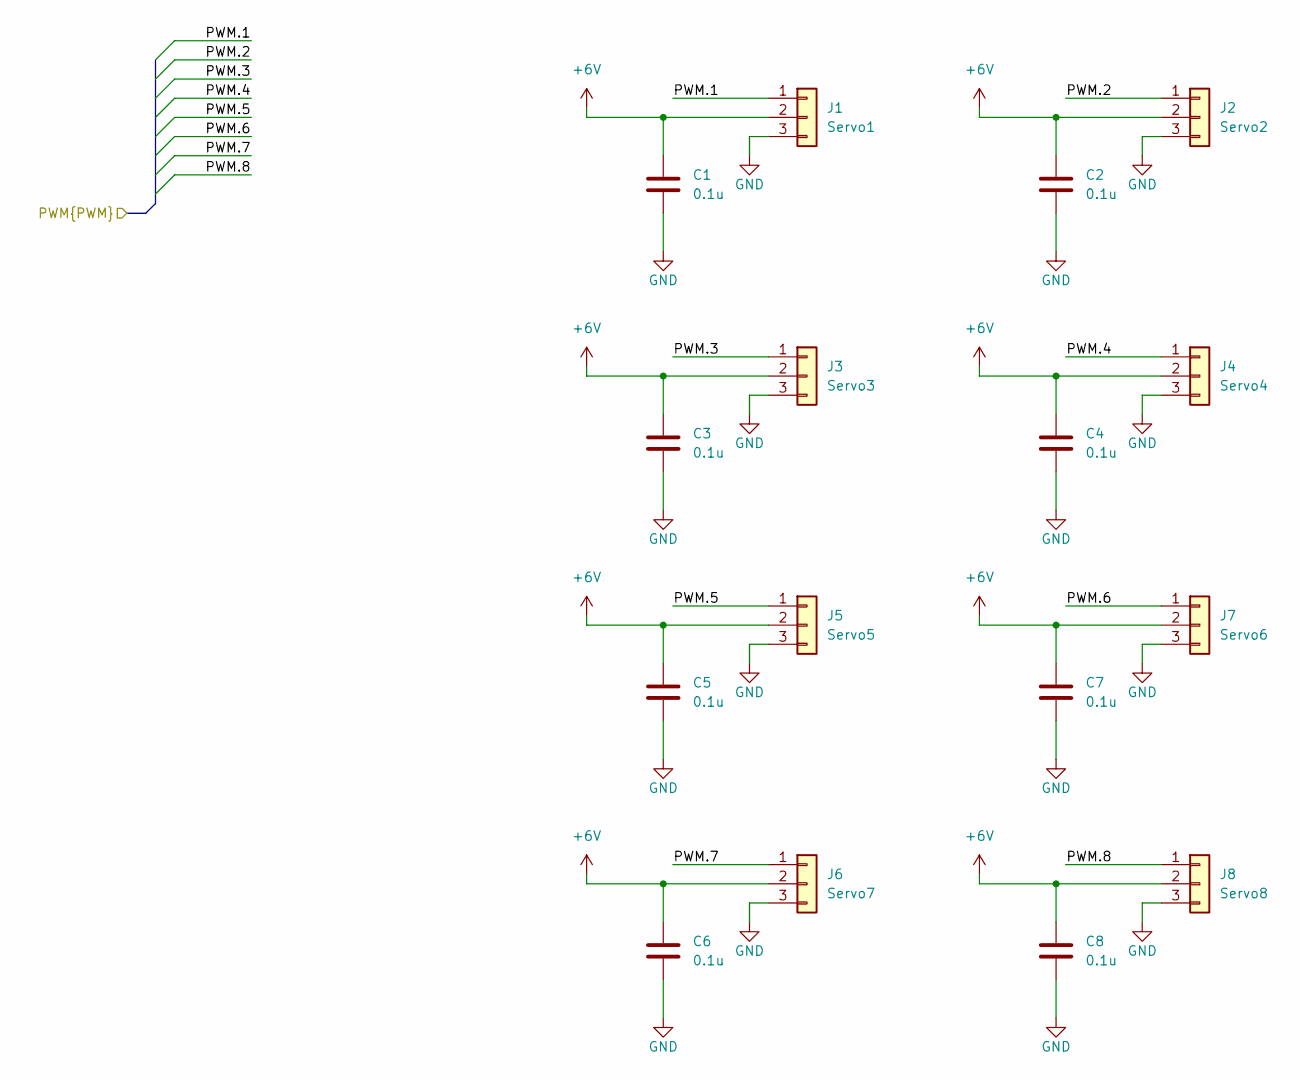
[picture p18: schematic servos.kicad_sch]

Parts:
C1, C2, C3, C4, C5, C6, C7, C8: 0.1u; C_0402
J1: Servo1; PinHeader_1x03_P2.54mm_Vertical
J2: Servo2; PinHeader_1x03_P2.54mm_Vertical
J3: Servo3; PinHeader_1x03_P2.54mm_Vertical
J4: Servo4; PinHeader_1x03_P2.54mm_Vertical
J5: Servo5; PinHeader_1x03_P2.54mm_Vertical
J6: Servo7; PinHeader_1x03_P2.54mm_Vertical
J7: Servo6; PinHeader_1x03_P2.54mm_Vertical
J8: Servo8; PinHeader_1x03_P2.54mm_Vertical

Connections:
+6V: C1.1, C2.1, C3.1, C4.1, C5.1, C6.1, C7.1, C8.1, J1.2, J2.2, J3.2, J4.2, J5.2, J6.2, J7.2, J8.2; also elsewhere on the board
/MCU/PWM.1: J1.1; also elsewhere on the board
/MCU/PWM.2: J2.1; also elsewhere on the board
/MCU/PWM.3: J3.1; also elsewhere on the board
/MCU/PWM.4: J4.1; also elsewhere on the board
/MCU/PWM.5: J5.1; also elsewhere on the board
/MCU/PWM.6: J7.1; also elsewhere on the board
/MCU/PWM.7: J6.1; also elsewhere on the board
/MCU/PWM.8: J8.1; also elsewhere on the board
GND: C1.2, C2.2, C3.2, C4.2, C5.2, C6.2, C7.2, C8.2, J1.3, J2.3, J3.3, J4.3, J5.3, J6.3, J7.3, J8.3; also elsewhere on the board

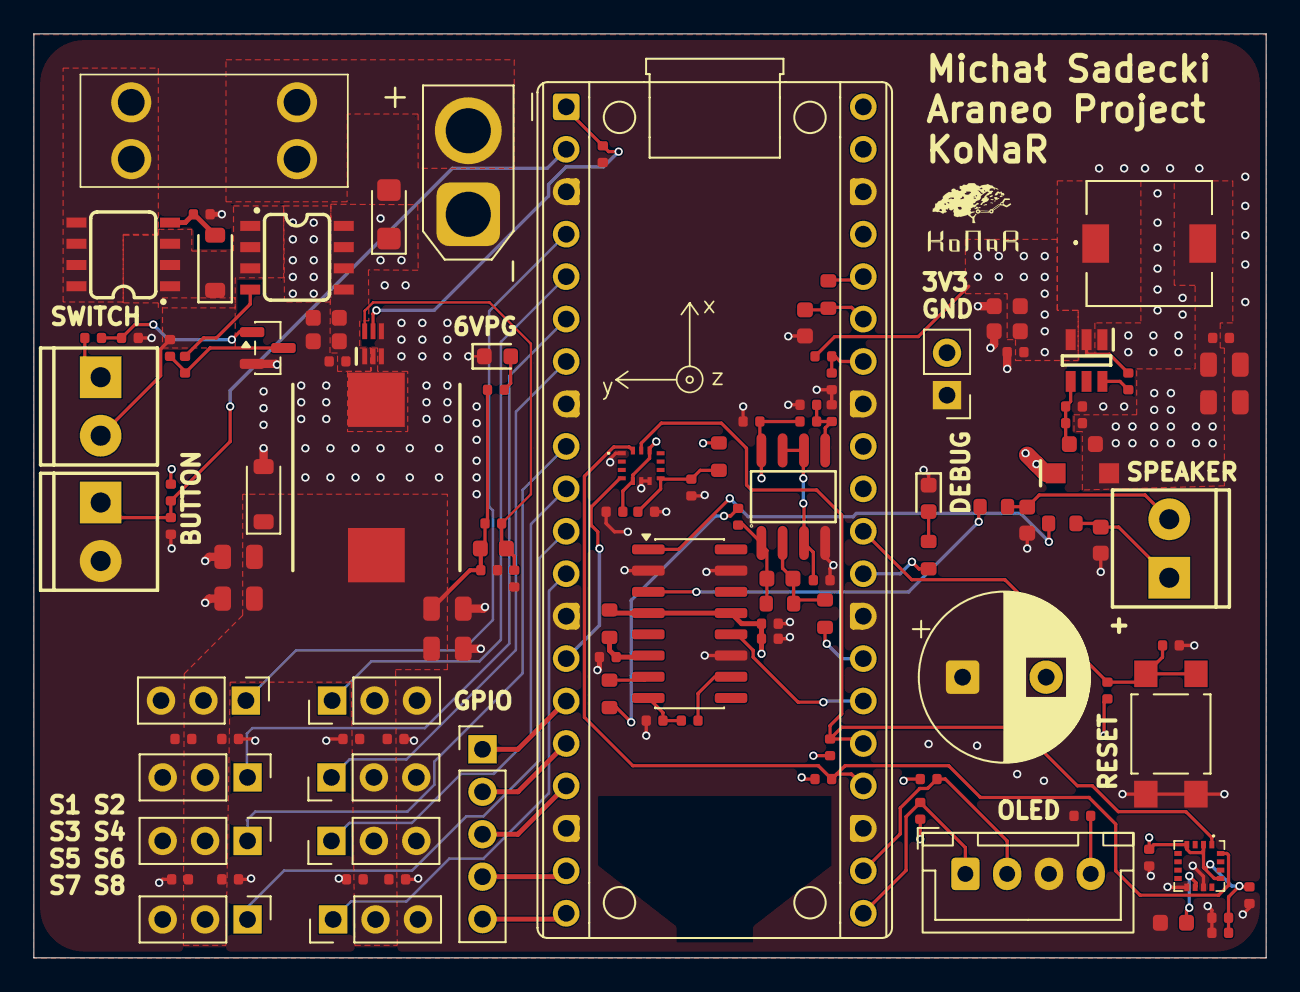
[picture p19: board araneo-mainboard.kicad_pcb from above]

Board: 4 copper layers, 73.8 x 55.3 mm, 116 parts (0 on the bottom side), 62 nets.

Other parts of the board:
konar1: LOGO; konar
