misadecki/araneo-project/firmware/src/icons.c

#include "icons.h"
#include <stdlib.h>
#include <strings.h>

static const uint8_t angry_face[] = {
   0xff, 0xff, 0xff, 0xff, 0xff, 0xff, 0xff, 0xff, 0xff, 0xff, 0xff, 0xff,
   0xff, 0xff, 0xff, 0xff, 0xff, 0xff, 0xff, 0xff, 0xff, 0xff, 0xff, 0xff,
   0xff, 0xff, 0xff, 0xff, 0xff, 0xff, 0xff, 0xff, 0xff, 0xff, 0xff, 0xff,
   0xff, 0xff, 0xff, 0xff, 0xff, 0xff, 0xff, 0xff, 0xff, 0xff, 0xff, 0xff,
   0xff, 0xff, 0xff, 0xff, 0xff, 0xff, 0xff, 0xff, 0xff, 0xff, 0xff, 0xff,
   0xff, 0xff, 0xff, 0xff, 0xff, 0xff, 0xff, 0xff, 0xff, 0xff, 0xff, 0xff,
   0xff, 0xff, 0xff, 0xff, 0xff, 0xff, 0xff, 0xff, 0xff, 0xff, 0xff, 0xff,
   0xff, 0xff, 0xff, 0xff, 0xff, 0xff, 0xff, 0xff, 0xff, 0xff, 0xff, 0xff,
   0xff, 0xff, 0xff, 0xff, 0xff, 0xff, 0xff, 0xff, 0xff, 0xff, 0xff, 0xff,
   0xff, 0xff, 0xff, 0xff, 0xff, 0xff, 0xff, 0xff, 0xff, 0xff, 0xff, 0xff,
   0xff, 0xff, 0xff, 0xff, 0xff, 0xff, 0xff, 0xff, 0xff, 0xff, 0xff, 0xff,
   0xff, 0xff, 0xff, 0xff, 0xff, 0xff, 0xff, 0xff, 0xff, 0xff, 0xff, 0xff,
   0xff, 0xff, 0xff, 0xff, 0xff, 0xff, 0xff, 0xff, 0xff, 0xff, 0xff, 0xff,
   0xff, 0xff, 0xff, 0xff, 0xff, 0xff, 0xff, 0xff, 0xff, 0xff, 0xff, 0xff,
   0xff, 0xff, 0xff, 0xff, 0xff, 0xff, 0xff, 0xff, 0xff, 0xff, 0xff, 0xff,
   0xff, 0xff, 0xff, 0xff, 0xff, 0xff, 0xff, 0xff, 0xff, 0xff, 0xff, 0xff,
   0xff, 0xff, 0xff, 0xff, 0xff, 0xff, 0xff, 0xff, 0xff, 0xff, 0xff, 0xff,
   0xff, 0xff, 0xff, 0xff, 0xff, 0xff, 0xff, 0xff, 0xff, 0xff, 0xff, 0xff,
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
   0xff, 0xff, 0xff, 0xff, 0xff, 0xff, 0xff, 0x03, 0x00, 0x00, 0x00, 0x00,
   0x00, 0x00, 0x00, 0x00, 0xff, 0xff, 0xff, 0xff, 0xff, 0xff, 0xff, 0x03,
   0x00, 0x00, 0x00, 0x00, 0x00, 0x00, 0x00, 0x00, 0xff, 0xff, 0xff, 0xff,
   0xff, 0xff, 0xff, 0xc3, 0xff, 0xff, 0xff, 0xff, 0xff, 0xff, 0xff, 0x0f,
   0xff, 0xff, 0xff, 0xff, 0xff, 0xff, 0xff, 0xe3, 0xff, 0xff, 0xff, 0xff,
   0xff, 0xff, 0xff, 0x1f, 0xff, 0xff, 0xff, 0xff, 0xff, 0xff, 0xff, 0xe3,
   0xff, 0xff, 0xff, 0xff, 0xff, 0xff, 0xff, 0x1f, 0xff, 0xff, 0xff, 0xff,
   0xff, 0xff, 0xff, 0xe3, 0xff, 0xff, 0xff, 0xff, 0xff, 0xff, 0xff, 0x1f,
   0xff, 0xff, 0xff, 0xff, 0xff, 0xff, 0xff, 0xe3, 0x01, 0x1e, 0xe0, 0x01,
   0x1e, 0xe0, 0x01, 0x1e, 0xff, 0xff, 0xff, 0xff, 0xff, 0xff, 0xff, 0xe3,
   0x01, 0x1e, 0xe0, 0x01, 0x1e, 0xe0, 0x01, 0x1e, 0xff, 0xff, 0xff, 0xff,
   0xff, 0xff, 0xff, 0xe3, 0x01, 0x1e, 0xe0, 0x01, 0x1e, 0xe0, 0x01, 0x1e,
   0xc0, 0xff, 0xff, 0xff, 0xff, 0xff, 0xff, 0xe3, 0x01, 0x1e, 0xe0, 0x01,
   0x1e, 0xe0, 0x01, 0x1e, 0xc0, 0xff, 0xff, 0xff, 0xff, 0xff, 0xff, 0xe3,
   0x01, 0x1e, 0xe0, 0x01, 0x1e, 0xe0, 0x01, 0x1e, 0xc0, 0xff, 0xff, 0xff,
   0xff, 0xff, 0xff, 0xe3, 0x01, 0x1e, 0xe0, 0x01, 0x1e, 0xe0, 0x01, 0x1e,
   0xc0, 0xff, 0xff, 0xff, 0xff, 0xff, 0xff, 0xe3, 0x01, 0x1e, 0xe0, 0x01,
   0x1e, 0xe0, 0x01, 0x1e, 0xc0, 0xff, 0xff, 0xff, 0xff, 0xff, 0xff, 0xe3,
   0x01, 0x1e, 0xe0, 0x01, 0x1e, 0xe0, 0x01, 0x1e, 0xc0, 0xff, 0xff, 0xff,
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

static const uint8_t * const icon_table[] = {
  [ICON_STANDARD] = standard_face,
  [ICON_ANGRY] = angry_face,
  [ICON_SMILE] = smile_face,
  [ICON_SAD] = sad_face,
  [ICON_ELIZA] = eliza_face,
  [ICON_EXCITED] = excited_face,
  [ICON_SLEEP] = sleep_face,
  [ICON_SHOCKED] = shocked_face,
  [ICON_KIDDING] = kidding_face,
  [ICON_BATTERY_1] = battery_1,
  [ICON_BATTERY_2] = battery_2,
  [ICON_BATTERY_3] = battery_3,
  [ICON_BATTERY_4] = battery_4,
  [ICON_BATTERY_FULL] = battery_full,
  [ICON_BATTERY_EMPTY] = battery_empty
};

const uint8_t *get_icon(icon_id_t icon) {
  if (icon < ICON_COUNT) {
    return icon_table[icon];
  }

  return icon_table[0];
}

static struct icon_arg_map icon_args[] = {
  {"standard", ICON_STANDARD},
  {"angry", ICON_ANGRY},
  {"smile", ICON_SMILE},
  {"sad", ICON_SAD},
  {"eliza", ICON_ELIZA},
  {"excited", ICON_EXCITED},
  {"sleep", ICON_SLEEP},
  {"shocked", ICON_SHOCKED},
  {"kidding", ICON_KIDDING}
};

int icon_id_from_str(const char *str, icon_id_t *id) {
  if (str == NULL || id == NULL)
    return -1;

  for (size_t i = 0; i < sizeof(icon_args) / sizeof(icon_args[0]); ++i) {
    if (strcasecmp(str, icon_args[i].arg) == 0) {
      *id = icon_args[i].id;
      return 0;
    }
  }

  return -2;
}
