misadecki/araneo-project/ros2_ws/src/quadruped_gait/tools/src/trajectory_test.cpp

#include "quadruped_gait/trajectory.hh"
#include "quadruped_kinematics/kinematics.hh"
#include <fstream>
#include <cmath>
#include <iomanip>
#include <stdexcept>
#include "gait_config.hh"
#include <iostream>

int main(int argc, char** argv) {
  if (argc < 1)
    throw std::runtime_error("You need to pass YAML path.");
  const std::string path = argv[1];
  GaitConfig cfg = {};
  try {
    cfg = loadGaitConfig(path);
  } catch (const std::exception& ex) {
    std::cerr << "Error loading file: " << path << ": " << ex.what() << '\n';
    return 2;
  }

  // q1_m, q2_st, w, Tsw, dq2
  const FootTrajectory traj(cfg.params);
  //LF, FR, BL, BR
  const quadruped::LegGeometry geom =
    {0.0598, 0.0436, -0.2633, 0.0105};
    // {0.0598, 0.0436, -0.2794, -0.0105};
    // {0.0598, 0.0436, -0.2794, 0.0096};
    // {0.0598, 0.0436, -0.2794, -0.0095};
  // femur_len, tibia_len, femur_ang, lateral
  const double T = traj.period();
  const double dt = 0.001;
  const int N = static_cast<int>(2 * T / dt);

  std::ofstream f("traj.csv");
  f << "t,q1,q2,x_fk,y_fk,z_fk\n";

  for (int i = 0; i <= N; ++i) {
    const double t = i * dt;
    const auto j = traj.at(t);

    const auto pos = quadruped::legFK({j.q1, j.q2}, geom);

    f << std::setprecision(12);
    f << t << ',' << j.q1 << ',' << j.q2 << ',' << pos.x << ',' << pos.y << ','
      << pos.z << '\n';
  }

  return 0;
}
