misadecki/araneo-project/ros2_ws/src/quadruped_gait/tools/charts.py

import pandas as pd, numpy as np, matplotlib.pyplot as plt

d = pd.read_csv("traj.csv")
dt = 0.001

# for c in ["q1", "q2"]:
#     d[c + "_vel"] = np.gradient(d[c], dt)
#     d[c + "_acc"] = np.gradient(d[c + "_vel"], dt)

# d.plot(x="t", y=["x_fk", "y_fk", "z_fk"])
# d.plot(x="t", y=["q1_acc", "q2_acc"])
# d.plot(x="y_fk", y="z_fk")
# d.plot(x="x_fk", y="z_fk")
# d.plot(x="t", y=["q1_vel", "q2_vel"])
# d.plot(x="t", y=["q1", "q2"])

for name in ("trot", "walk"):
    d = pd.read_csv(f"gait_{name}.csv")
    fig, ax = plt.subplots(2, 1, sharex=True)
    for i, leg in enumerate(("LF", "RF", "LB", "RB")):
        ax[0].plot(d.t, d[f"q1_{i}"], label=leg)
        ax[1].plot(d.t, d[f"q2_{i}"], label=leg)
    ax[0].set_ylabel("q1 [deg]");
    ax[1].set_ylabel("q2 [deg]");
    ax[0].set_xlabel("t [s]");
    ax[0].legend()
    fig.suptitle(name)
plt.show()
