misadecki/araneo-project/(commit log)

2026-07-05 electronics: add libs and fundamental schematic
    [araneo-mainboard.kicad_sch]
2026-07-06 electronics: full schematics
    [araneo-mainboard.kicad_sch]
2026-07-15 electronics: prepare pcb
    [araneo-mainboard.kicad_pcb, araneo-mainboard.kicad_sch]
2026-07-15 electronics: full PCB
    [araneo-mainboard.kicad_pcb, araneo-mainboard.kicad_sch]
2026-07-16 electronics: add pin labels on pcb
    [araneo-mainboard.kicad_pcb]
2026-07-20 electronics: fix schematic and prepare for wiring
    [araneo-mainboard.kicad_pcb, araneo-mainboard.kicad_sch]
2026-07-20 electronics: add speaker
    [araneo-mainboard.kicad_pcb, araneo-mainboard.kicad_sch]
2026-07-21 electronics: add footprints
    [araneo-mainboard.kicad_pcb, araneo-mainboard.kicad_sch]
2026-07-21 electronics: pcb v2
    [araneo-mainboard.kicad_pcb, araneo-mainboard.kicad_sch]
2026-07-22 electronics: board pcb
    [araneo-mainboard.kicad_pcb, araneo-mainboard.kicad_sch]
2026-07-22 electronics: add button
    [araneo-mainboard.kicad_pcb, araneo-mainboard.kicad_sch]
2026-07-22 electronics: add capacitor filters and Schottky diode
    [araneo-mainboard.kicad_pcb, araneo-mainboard.kicad_sch]
2026-07-29 electronics: new buck, regulator and improve schematic
    [araneo-mainboard.kicad_pcb, araneo-mainboard.kicad_sch]
2026-07-29 electronics: pcb v3
    [araneo-mainboard.kicad_pcb, araneo-mainboard.kicad_sch]
2026-08-04 electronics: add bmi270 and second buck
    [araneo-mainboard.kicad_pcb, araneo-mainboard.kicad_sch, imu.kicad_sch]
2026-08-04 electronics: add diode indicator
    [araneo-mainboard.kicad_pcb, araneo-mainboard.kicad_sch]
2026-08-05 electronics: add magnetometer
    [araneo-mainboard.kicad_pcb, araneo-mainboard.kicad_sch, magnetometer.kicad_sch]
2026-08-06 electronics: add 100n capacitors
    [araneo-mainboard.kicad_pcb, araneo-mainboard.kicad_sch, imu.kicad_sch, magnetometer.kicad_sch]
2026-08-06 electronics: change capacitor footprint
    [araneo-mainboard.kicad_pcb, araneo-mainboard.kicad_sch]
2026-08-09 electronics: remove unnecessary capacitors, add net labels, change screw terminal to JST_XH
    [araneo-mainboard.kicad_pcb, araneo-mainboard.kicad_sch, imu.kicad_sch, magnetometer.kicad_sch]
2026-08-09 electronics: change bucks layout
    [araneo-mainboard.kicad_pcb, araneo-mainboard.kicad_sch, imu.kicad_sch, magnetometer.kicad_sch]
2026-08-09 electronics: connect bucks
    [araneo-mainboard.kicad_pcb]
2026-08-09 electronics: add vias
    [araneo-mainboard.kicad_pcb]
2026-08-09 electronics: add credits
    [araneo-mainboard.kicad_pcb]
2026-08-10 electronics: change buck layout
    [araneo-mainboard.kicad_pcb, araneo-mainboard.kicad_sch]
2026-08-11 electronics: change 22u footprint
    [araneo-mainboard.kicad_pcb, araneo-mainboard.kicad_sch]
2026-08-12 electronics: move uC to have USB inlined with border
    [araneo-mainboard.kicad_pcb, araneo-mainboard.kicad_sch]
2026-08-12 mechanics: add first assembly
    [araneo-cad.step, araneo-cad.stl]
2026-08-12 electronics: remove cutout
    [araneo-mainboard.kicad_pcb]
2026-08-13 electronics: move elements to fulfill jlcpcb rules and add gerber files to gitignore
    [araneo-mainboard.kicad_pcb]
2026-08-18 mechanics: first version of model
    [araneo-cad.step]
2026-08-21 mechanics: add features after consult with mechanical engineer, exchange too big stl
    [araneo-cad.step]
2026-08-25 prepare Zephyr structure, OLED device tree and remove one model from PCB
    [araneo-mainboard.kicad_pcb]
2026-08-26 add battery icons and restructure code
2026-08-27 mechanics: version 1 to print
    [araneo-cad.stl]
2026-08-27 mechanics: fix screws and hooks
    [araneo-cad.stl]
2026-09-01 add servo control by PWM
    [pwm-servo.yaml]
2026-09-01 add servos api
2026-09-01 add commands interpreter for servos
2026-09-02 ros: add urdf model and prepare structure
    [araneo.urdf, battery.stl, body_bottom.stl, body_top.stl, electronics.stl, femur_left.stl, femur_right.stl, head.stl]
2026-09-02 mechanics: fix mates
    [araneo-cad.stl]
2026-09-04 mechanics: fix print and measure issues
    [araneo-cad.stl, araneo-mainboard.kicad_pcb]
2026-09-04 mechanics: add usb cutting
    [araneo-cad.stl]
2026-09-06 firmware: add button for switching oled state
2026-09-06 firmware: add debug led
2026-09-07 firmware: add buck enabling
2026-09-08 mechanics: change structure for cables and screws
    [araneo-cad.stl]
2026-09-14 mechanics: fix snap fits and bore coaxiality in femur
    [araneo-cad.stl]
2026-09-22 araneo mainboard v2 schematic preparation
    [araneo-mainboard.kicad_pcb, araneo-mainboard.kicad_sch, imu.kicad_sch, magnetometer.kicad_sch, mcu.kicad_sch, power.kicad_sch, servo_power.kicad_sch, servos.kicad_sch]
2026-09-22 add components schematics
    [araneo-mainboard.kicad_sch, imu.kicad_sch, magnetometer.kicad_sch, mcu.kicad_sch, pico-power.kicad_sch, power.kicad_sch, servo_power.kicad_sch, speaker.kicad_sch]
2026-09-22 add speaker schematic
    [araneo-mainboard.kicad_sch, mcu.kicad_sch, speaker.kicad_sch]
2026-09-22 electronics: assign footprints
    [imu.kicad_sch, magnetometer.kicad_sch, mcu.kicad_sch, pico-power.kicad_sch, power.kicad_sch, servo_power.kicad_sch, servos.kicad_sch, speaker.kicad_sch]
2026-10-02 add first layout
    [araneo-mainboard.kicad_pcb, mcu.kicad_sch, power.kicad_sch, servo_power.kicad_sch, speaker.kicad_sch]
2026-10-02 add missing components
    [araneo-mainboard.kicad_pcb, araneo-mainboard.kicad_sch, imu.kicad_sch, magnetometer.kicad_sch, mcu.kicad_sch, oled.kicad_sch]
2026-10-02 add layout
    [araneo-mainboard.kicad_pcb]
2026-10-02 complete layout, revision need
    [araneo-mainboard.kicad_pcb, pico-power.kicad_sch]
2026-10-03 add inverse kinematics
2026-10-03 electronics: update bom
    [mcu.kicad_sch, oled.kicad_sch, pico-power.kicad_sch, power.kicad_sch, servo_power.kicad_sch, servos.kicad_sch, speaker.kicad_sch]
2026-10-06 improve schematic and layout, add LCSC parts
    [araneo-mainboard.kicad_pcb, imu.kicad_sch, magnetometer.kicad_sch, mcu.kicad_sch, oled.kicad_sch, pico-power.kicad_sch, power.kicad_sch, servo_power.kicad_sch]
2026-10-07 electronics: add imu axes
    [araneo-mainboard.kicad_pcb]
2026-10-08 electronics: fix bom
    [araneo-mainboard.kicad_pcb]
2026-10-09 electronics: fix something
    [araneo-mainboard.kicad_pcb]
2026-11-02 add rviz visualization, fix urdf and add IK
2026-11-03 add new joints and fix leg directions
2026-11-03 add leg params script
2026-11-05 add checking leg params from urdf script
2026-11-05 fix kinematics params
2026-11-05 add kinematics tests header
2026-11-05 add kinematics test
2026-11-12 add LegConfig struct and change frame functions arguments
2026-11-13 remove leg params
2026-11-13 fix urdf angles
2026-11-14 add servos message to gait node
